Skyhawkson/Skyhawkson-KiCAD-Libraries/Models/HW_MPR_Long-Port_No-Gage.STEP

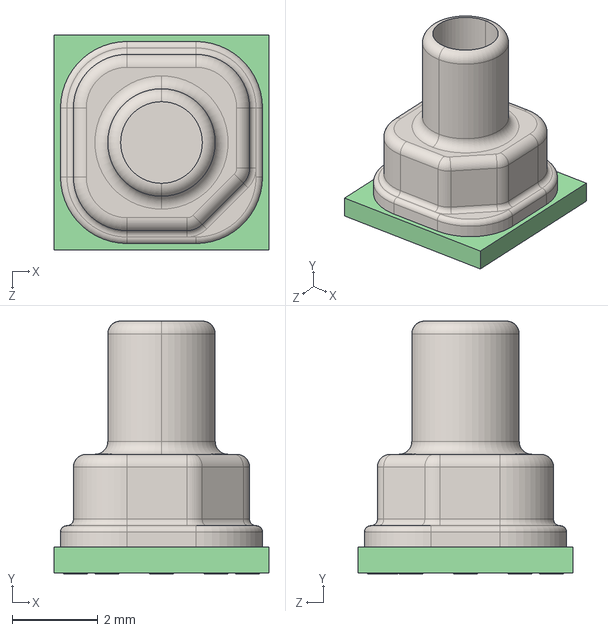
[picture p4: CAD file, 2024-02-28]
Models/HW_MPR_Long-Port_No-Gage.STEP
5.00 x 5.88 x 5.00 mm
