Skyhawkson/Skyhawkson-KiCAD-Libraries/Models/HIROSE_FH12-16S-1SH.STEP

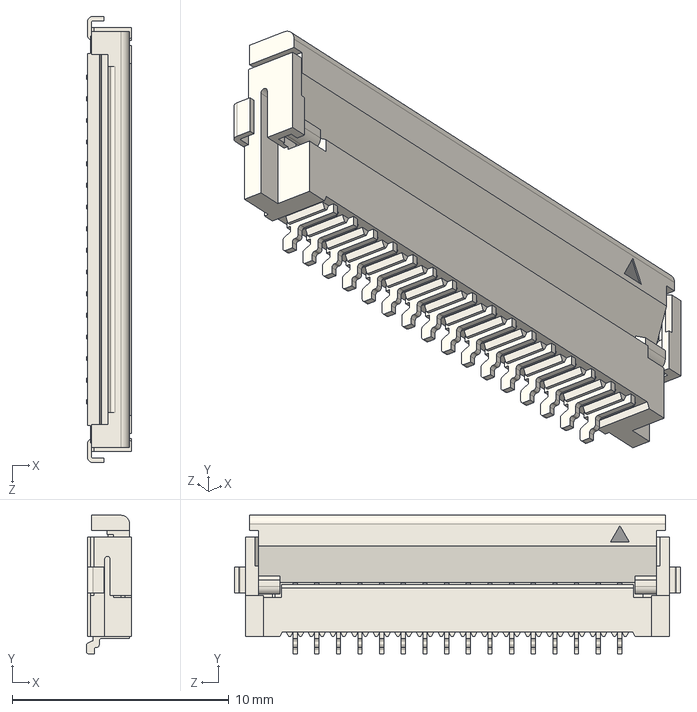
[picture p5: CAD file, 2024-02-18]
Models/HIROSE_FH12-16S-1SH.STEP
2.10 x 6.40 x 20.6 mm
