Skyhawkson/Skyhawkson-KiCAD-Libraries/Models/RPI_RP2040.STEP

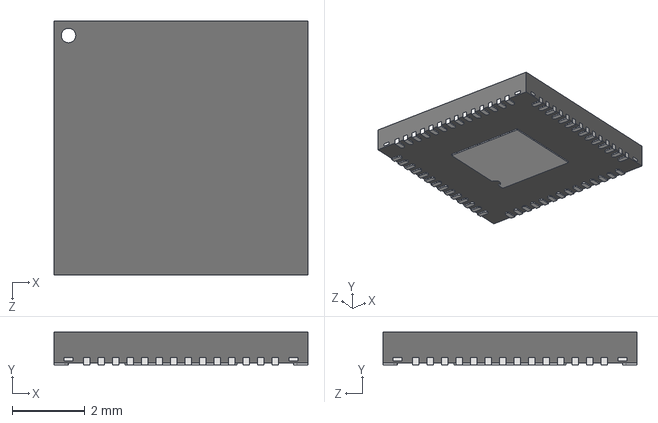
[picture p6: CAD file, 2024-02-08]
Models/RPI_RP2040.STEP
7.00 x 0.9 x 7.00 mm
