Skyhawkson/Skyhawkson-KiCAD-Libraries/Models/KEYSTONE_1043P.STEP

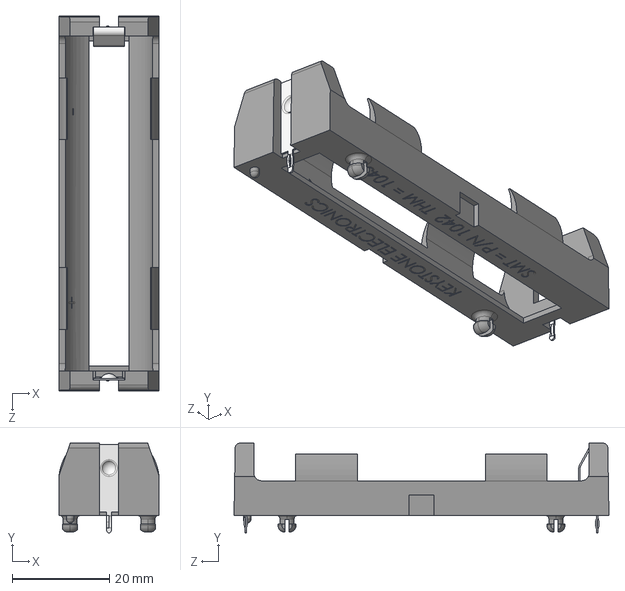
[picture p7: CAD file, 2024-01-29]
Models/KEYSTONE_1043P.STEP
20.7 x 18.5 x 77.1 mm
