Skyhawkson/Skyhawkson-KiCAD-Libraries/Models/WE_WL-SUTW.STEP

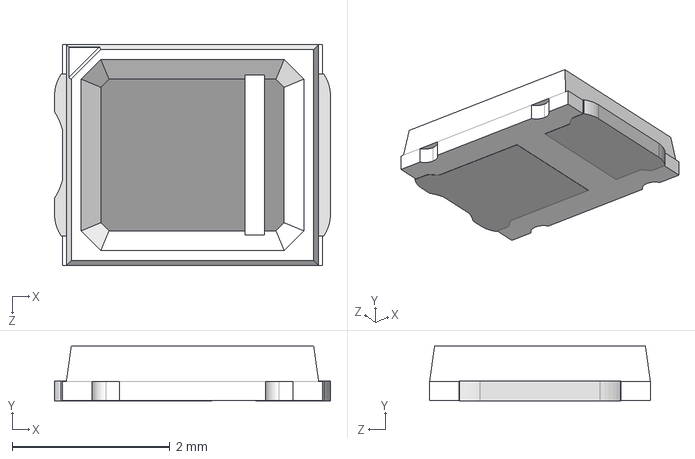
[picture p8: CAD file, 2024-01-17]
Models/WE_WL-SUTW.STEP
3.50 x 0.695 x 2.80 mm
