Skyhawkson/Skyhawkson-KiCAD-Libraries/Models/GENERIC_0402_CAP.step

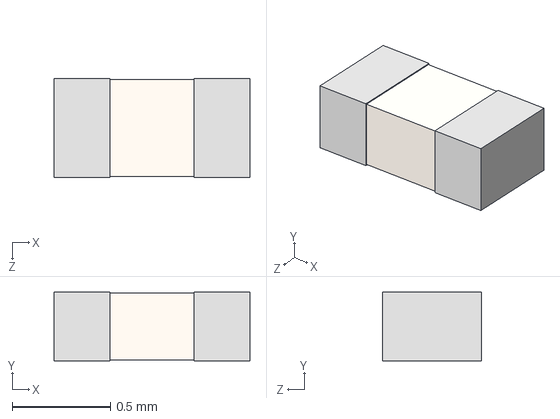
[picture p9: CAD file, 2023-11-19]
Models/GENERIC_0402_CAP.step
0.996 x 0.349 x 0.501 mm
