Skyhawkson/Skyhawkson-KiCAD-Libraries/Models/BIVAR_SLP3-150-100-F.IGS

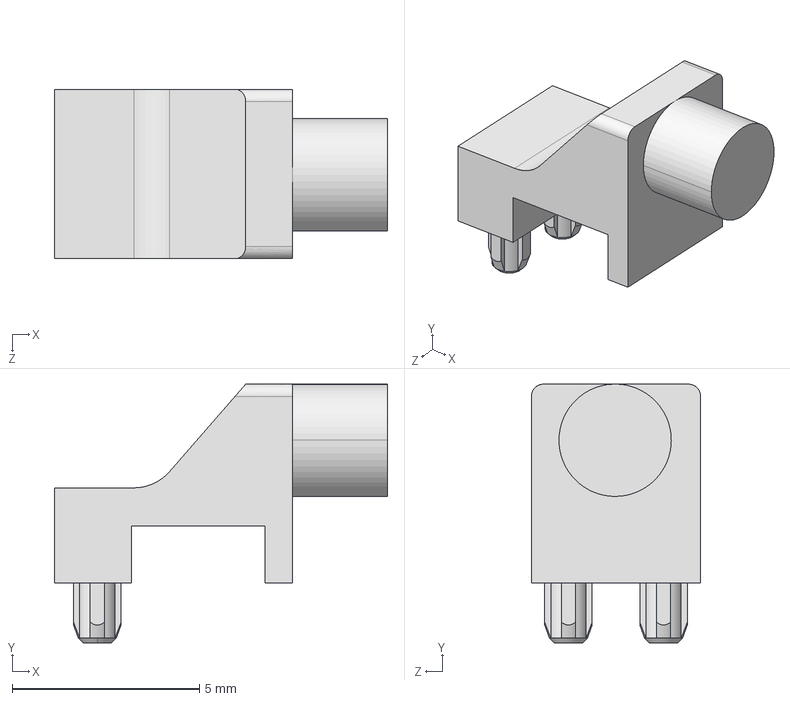
[picture p10: CAD file, 2023-11-09]
Models/BIVAR_SLP3-150-100-F.IGS
8.89 x 6.91 x 4.52 mm
