Skyhawkson/Skyhawkson-KiCAD-Libraries/Models/BIVAR_SLP3-150-250-F.IGS

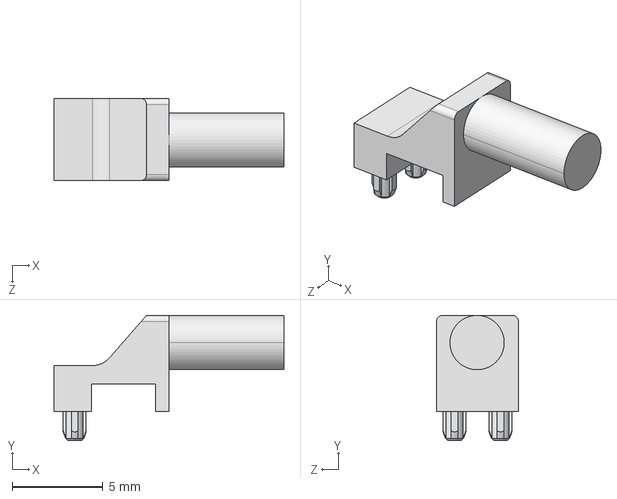
[picture p11: CAD file, 2023-11-05]
Models/BIVAR_SLP3-150-250-F.IGS
12.7 x 6.91 x 4.52 mm
