Skyhawkson/Skyhawkson-KiCAD-Libraries/Models/BOURNS_CAT16-F4.STEP

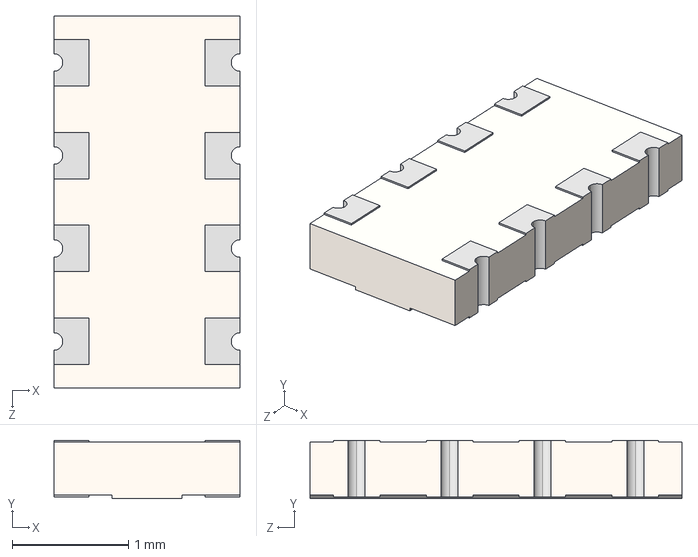
[picture p12: CAD file, 2023-10-05]
Models/BOURNS_CAT16-F4.STEP
1.60 x 0.5 x 3.20 mm
