Skyhawkson/Skyhawkson-KiCAD-Libraries/Models/TI_PW0020A_(TSSOP-20).STEP

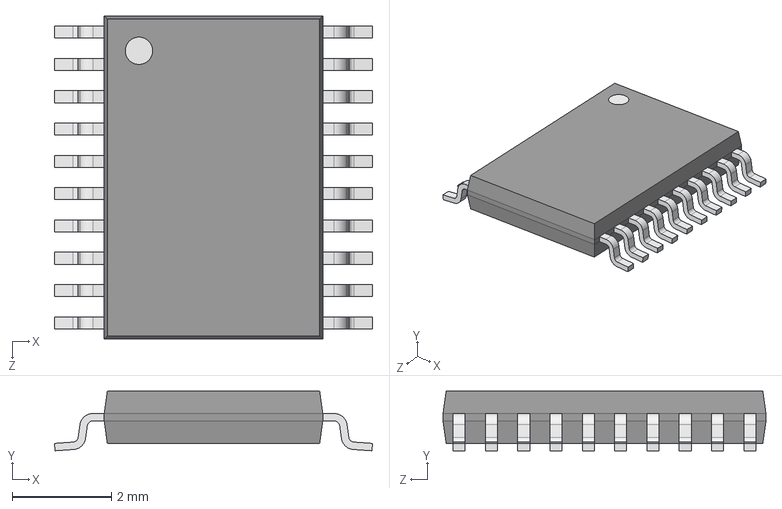
[picture p13: CAD file, 2023-09-29]
Models/TI_PW0020A_(TSSOP-20).STEP
6.40 x 1.20 x 6.50 mm
