Skyhawkson/Skyhawkson-KiCAD-Libraries/Models/WE-CNSW-0603.STEP

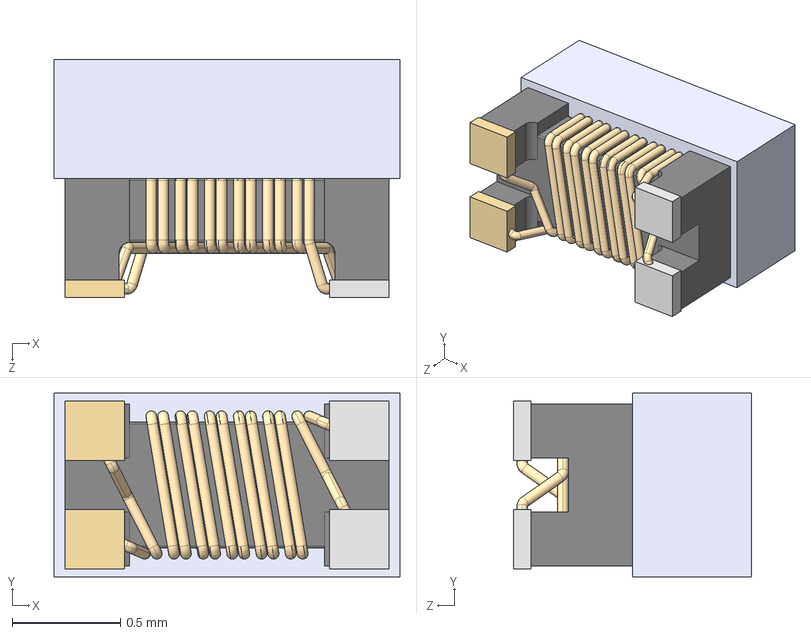
[picture p14: CAD file, 2023-06-05]
Models/WE-CNSW-0603.STEP
1.60 x 0.85 x 1.10 mm
Epoxy.stp.STEP.STEP
Ferrite.stp.STEP.STEP
Ferrite-0.stp.STEP.STEP
Ferrite-1.stp.STEP.STEP
Pins.stp.STEP.STEP
Pins-2.stp.STEP.STEP
Pins-3.stp.STEP.STEP
Pins-4.stp.STEP.STEP
