Skyhawkson/Skyhawkson-KiCAD-Libraries/Models/BOURNS_SRP5030TA.STEP

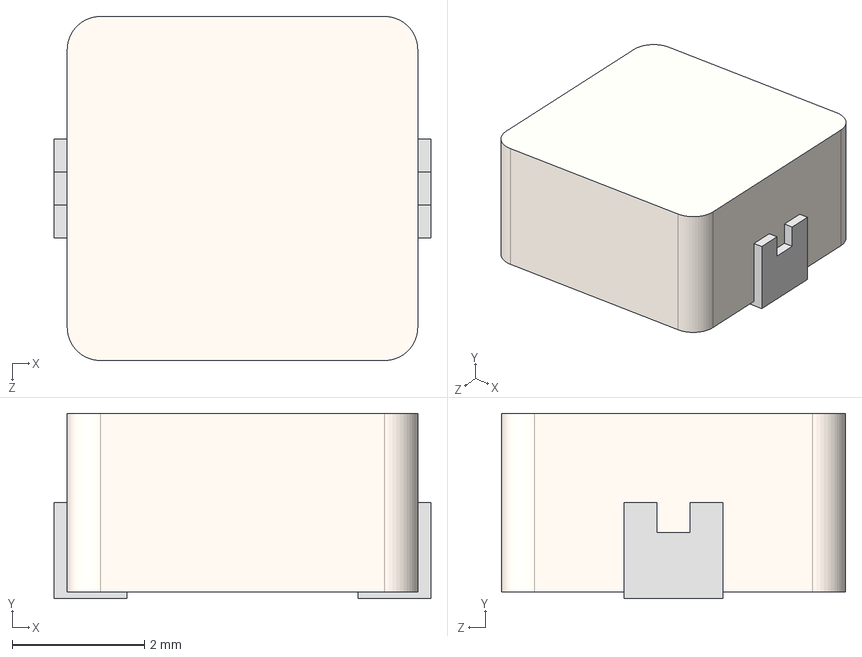
[picture p15: CAD file, 2023-06-05]
Models/BOURNS_SRP5030TA.STEP
5.70 x 2.80 x 5.20 mm
