Skyhawkson/Skyhawkson-KiCAD-Libraries/Models/GENERIC_DO-214BA.STEP

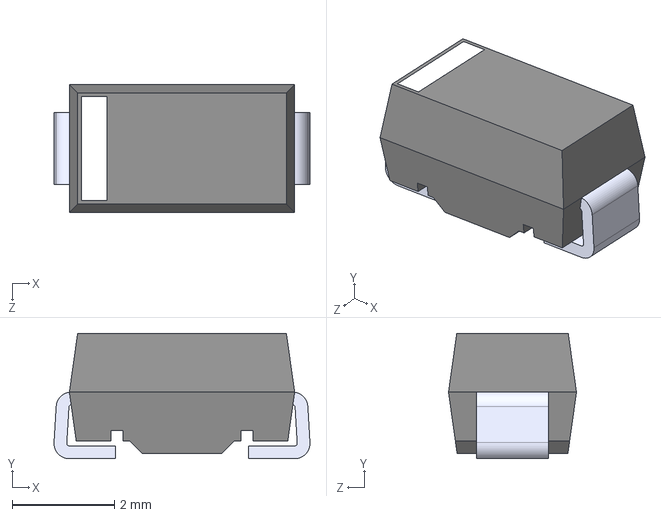
[picture p16: CAD file, 2023-05-29]
Models/GENERIC_DO-214BA.STEP
5.00 x 2.45 x 2.50 mm
