Skyhawkson/Skyhawkson-KiCAD-Libraries/Models/SAMTEC_LSS-120-02-F-DV-A.stp

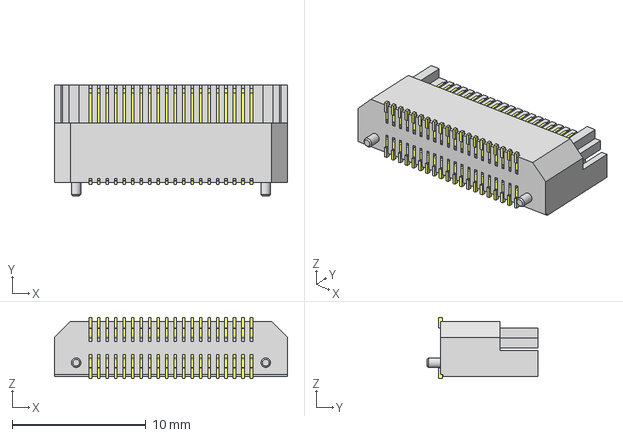
[picture p17: CAD file, 2023-05-29]
Models/SAMTEC_LSS-120-02-F-DV-A.stp
17.4 x 8.30 x 4.60 mm
C-185-20-02
LSS-20-02-A-_socket
