Skyhawkson/Skyhawkson-KiCAD-Libraries/Models/TOR_SOT89-5.STEP

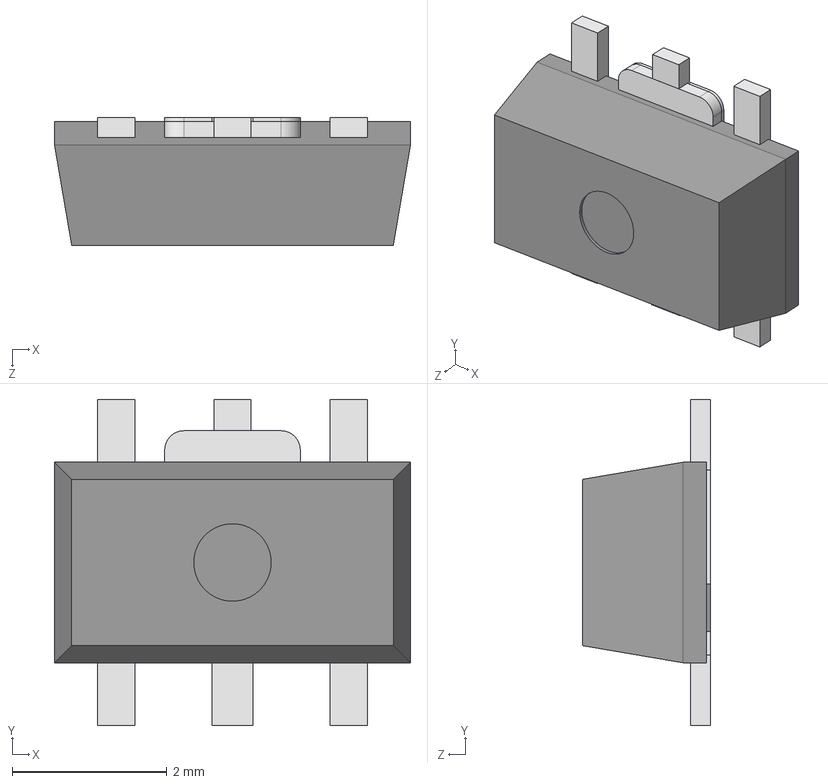
[picture p18: CAD file, 2023-04-02]
Models/TOR_SOT89-5.STEP
4.60 x 4.22 x 1.65 mm
