Skyhawkson/Skyhawkson-KiCAD-Libraries/Models/LF_494_(0603).STEP

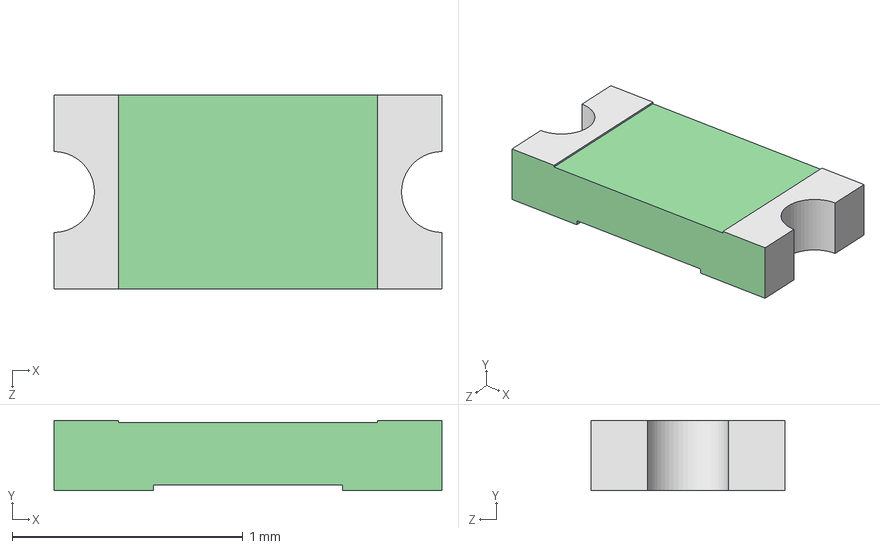
[picture p19: CAD file, 2023-03-20]
Models/LF_494_(0603).STEP
1.68 x 0.305 x 0.84 mm
