Skyhawkson/Skyhawkson-KiCAD-Libraries/Models/AMP_MSPE-J2L0-B01-REVT3.STEP

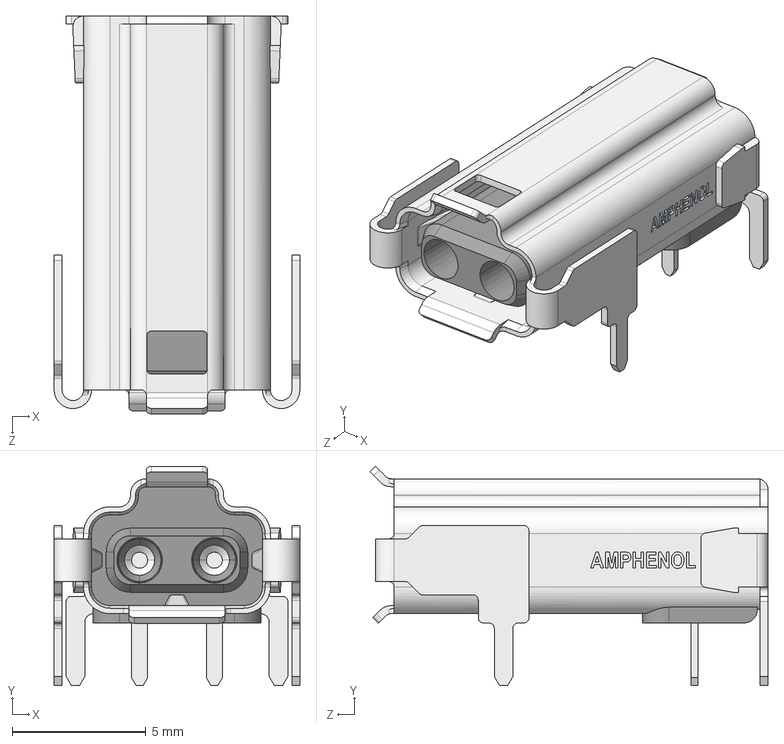
[picture p20: CAD file, 2023-03-18]
Models/AMP_MSPE-J2L0-B01-REVT3.STEP
9.20 x 8.22 x 14.9 mm
