Skyhawkson/Skyhawkson-KiCAD-Libraries/Models/AD_ADIN1110.step

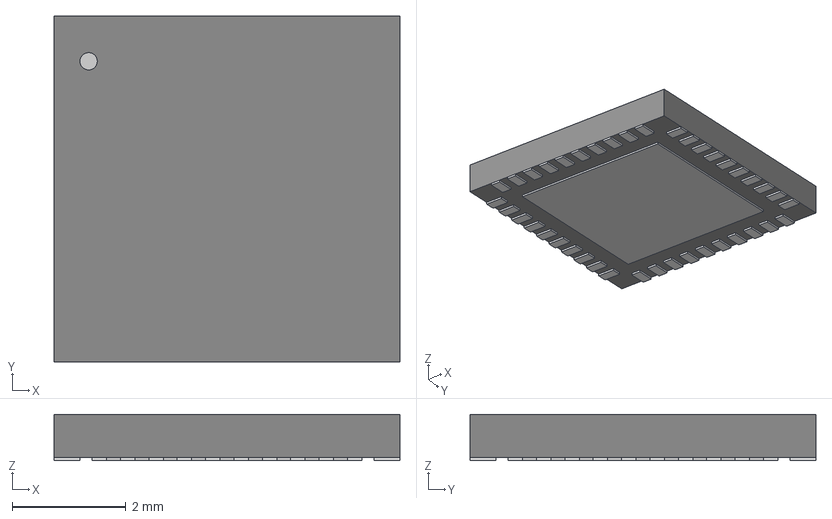
[picture p21: CAD file, 2023-03-06]
Models/AD_ADIN1110.step
6.10 x 6.10 x 0.815 mm
