Skyhawkson/Skyhawkson-KiCAD-Libraries/Models/GENERIC_SOT23-6.STEP

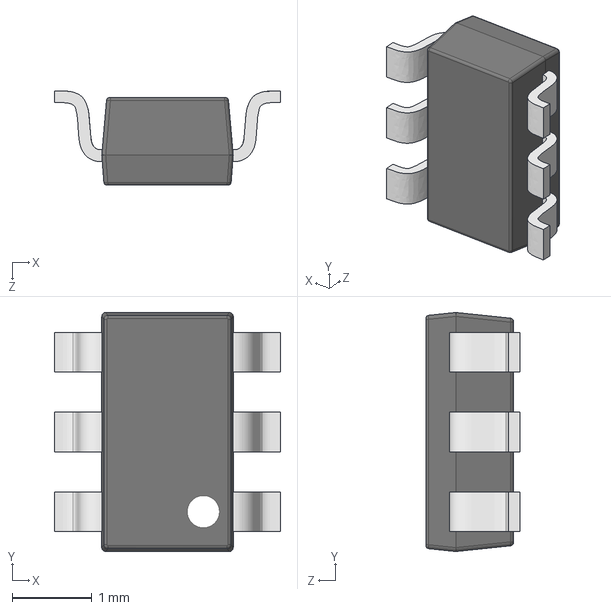
[picture p22: CAD file, 2023-02-12]
Models/GENERIC_SOT23-6.STEP
2.84 x 3.00 x 1.18 mm
