Skyhawkson/Skyhawkson-KiCAD-Libraries/Models/KEYSTONE_575-4.STEP

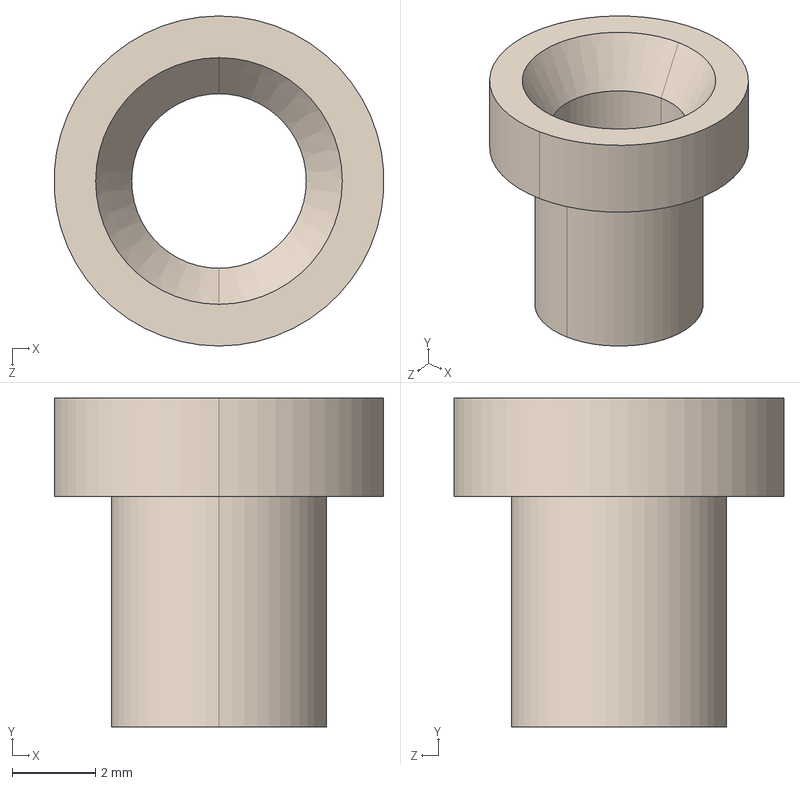
[picture p23: CAD file, 2023-01-21]
Models/KEYSTONE_575-4.STEP
7.91 x 7.89 x 7.92 mm
