Skyhawkson/Skyhawkson-KiCAD-Libraries/Models/MAXIM_W352A2+1.STEP

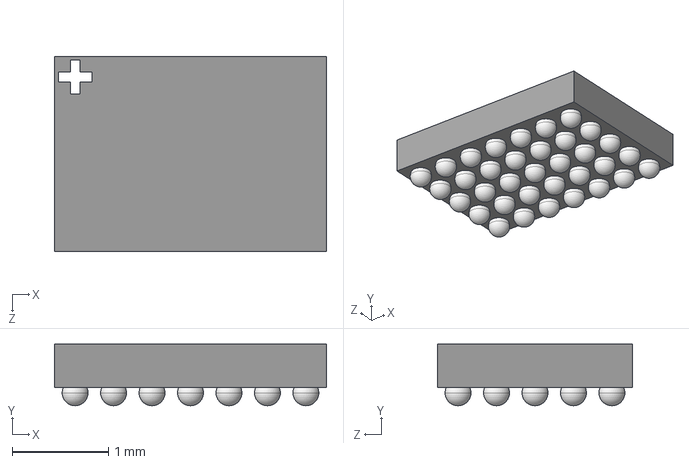
[picture p24: CAD file, 2023-01-15]
Models/MAXIM_W352A2+1.STEP
2.83 x 0.64 x 2.03 mm
