Skyhawkson/Skyhawkson-KiCAD-Libraries/Models/ROHM_HSMT8_NOMINAL.step

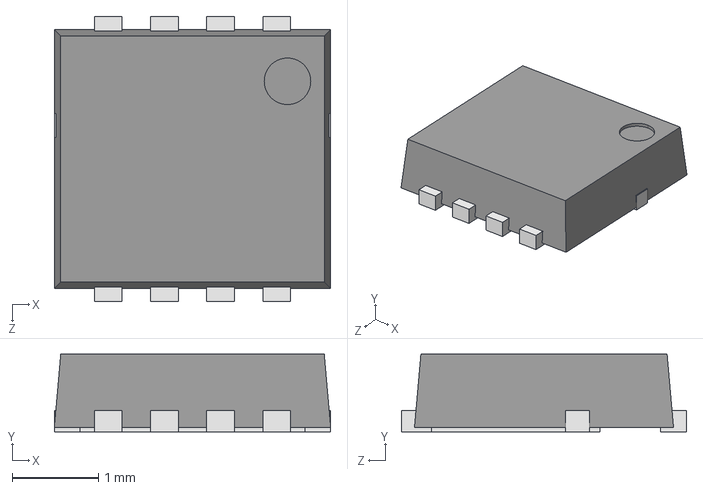
[picture p25: CAD file, 2022-08-25]
Models/ROHM_HSMT8_NOMINAL.step
3.20 x 0.9 x 3.30 mm
