Skyhawkson/Skyhawkson-KiCAD-Libraries/Models/DIODES_POWERDI5.step

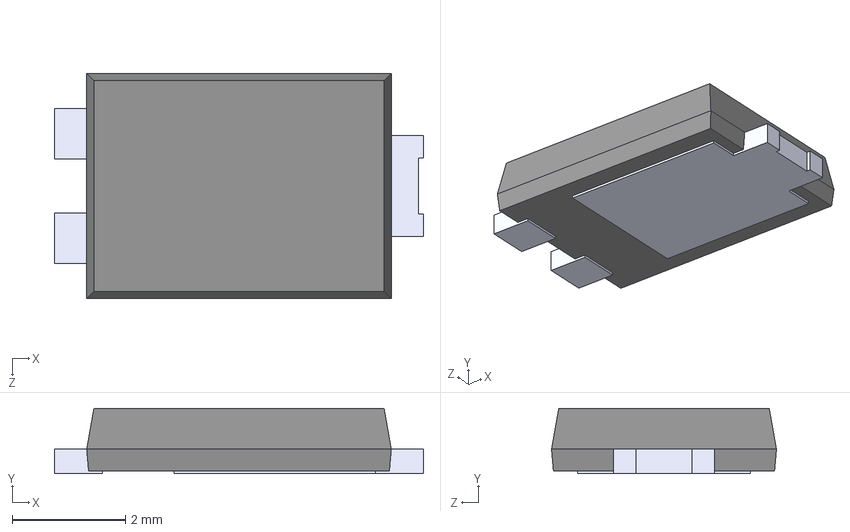
[picture p26: CAD file, 2022-08-09]
Models/DIODES_POWERDI5.step
6.50 x 1.15 x 3.97 mm
