Skyhawkson/Skyhawkson-KiCAD-Libraries/Models/GENERIC_0603_RES.step

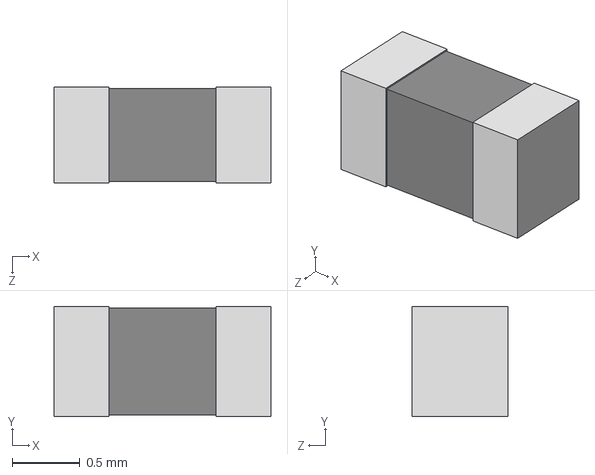
[picture p27: CAD file, 2022-08-09]
Models/GENERIC_0603_RES.step
1.60 x 0.812 x 0.711 mm
