Skyhawkson/Skyhawkson-KiCAD-Libraries/Models/GENERIC_0805_RES.step

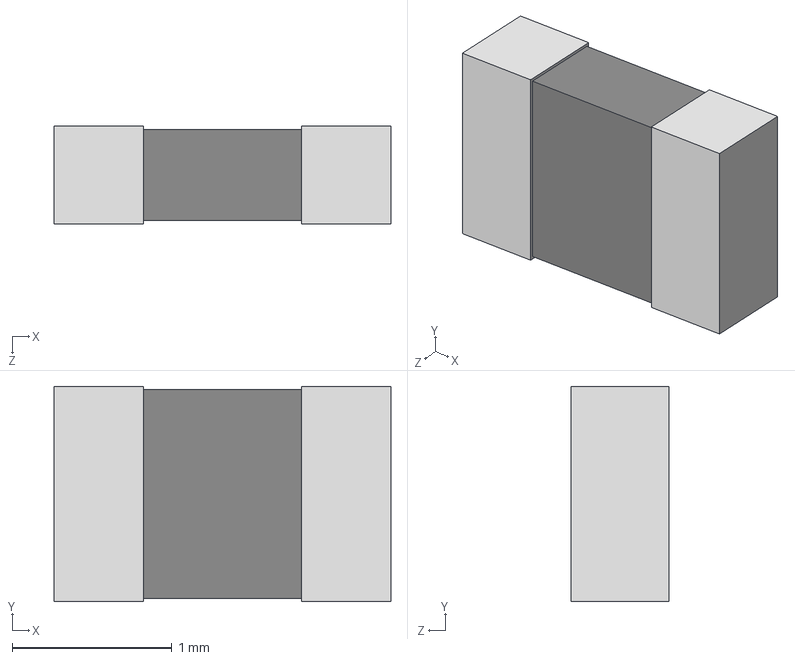
[picture p28: CAD file, 2022-08-09]
Models/GENERIC_0805_RES.step
2.11 x 1.35 x 0.61 mm
