Skyhawkson/Skyhawkson-KiCAD-Libraries/Models/TOR-SOT25.step

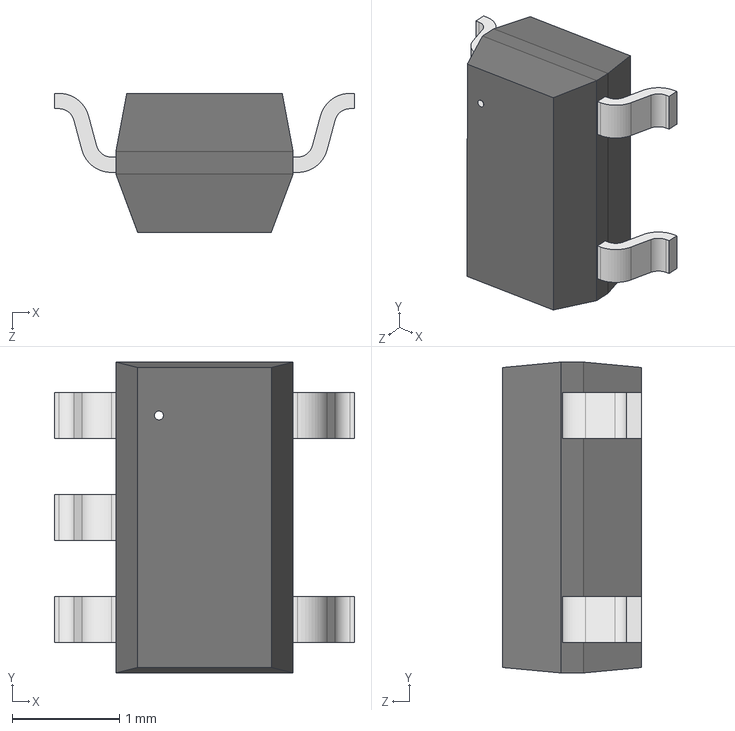
[picture p29: CAD file, 2022-07-27]
Models/TOR-SOT25.step
2.79 x 2.90 x 1.30 mm
