Skyhawkson/Skyhawkson-KiCAD-Libraries/Models/ROHM_HTSOP-J8.step

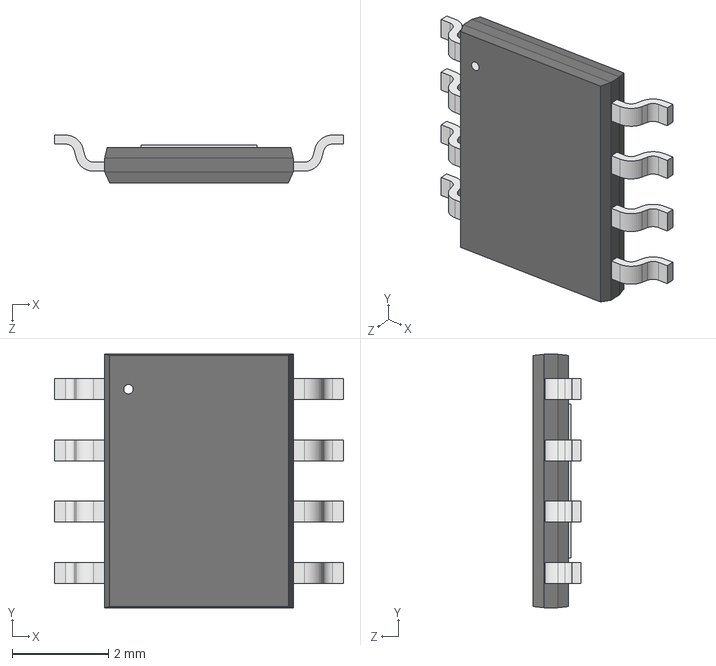
[picture p30: CAD file, 2022-07-27]
Models/ROHM_HTSOP-J8.step
5.99 x 5.26 x 0.993 mm
