Skyhawkson/Skyhawkson-KiCAD-Libraries/Models/MIC_SOT23-5LD-PL-1.step

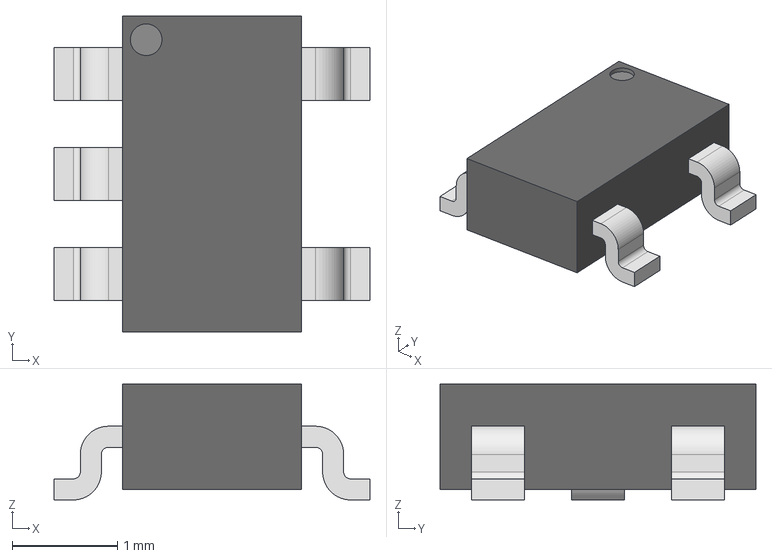
[picture p31: CAD file, 2022-07-27]
Models/MIC_SOT23-5LD-PL-1.step
3.00 x 3.00 x 1.10 mm
