Skyhawkson/Skyhawkson-KiCAD-Libraries/Models/CK_PTS815.step

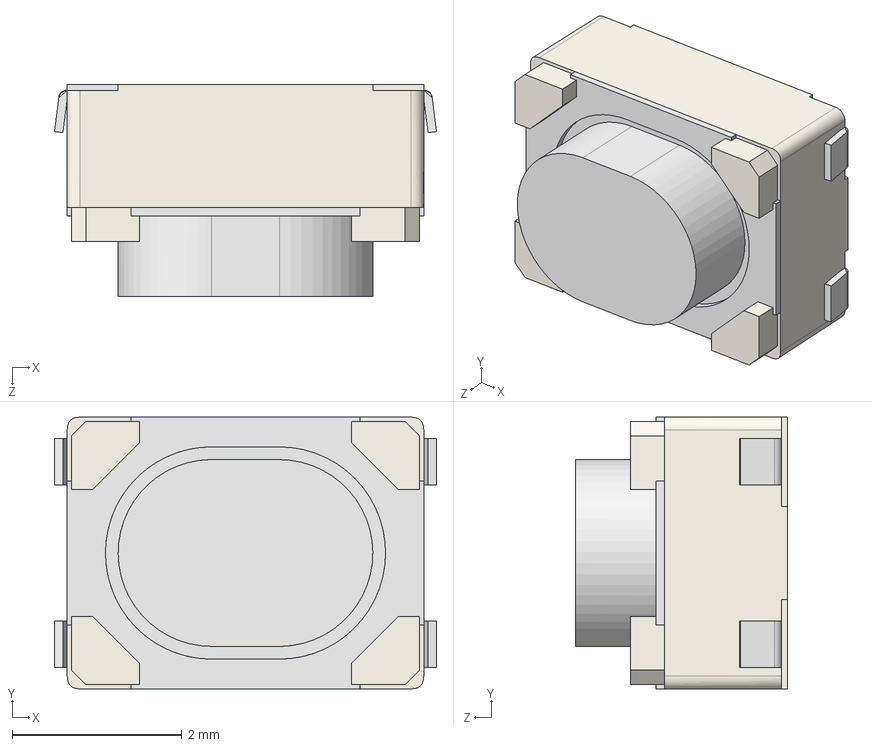
[picture p32: CAD file, 2022-07-25]
Models/CK_PTS815.step
4.50 x 3.20 x 2.50 mm
1.stp
1-0.stp
1-1.stp
