Skyhawkson/Skyhawkson-KiCAD-Libraries/Models/MURATA_PKMCS.step

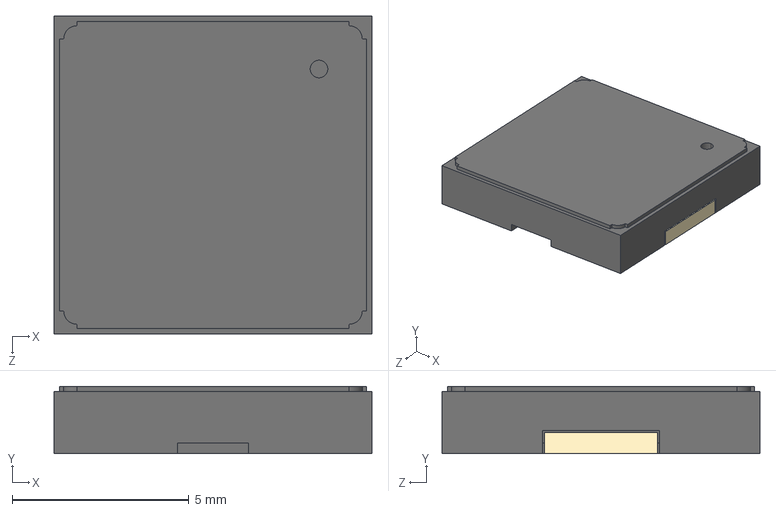
[picture p33: CAD file, 2022-07-25]
Models/MURATA_PKMCS.step
9.00 x 1.90 x 9.00 mm
