Skyhawkson/Skyhawkson-KiCAD-Libraries/Models/HARWIN_S1751-XX.step

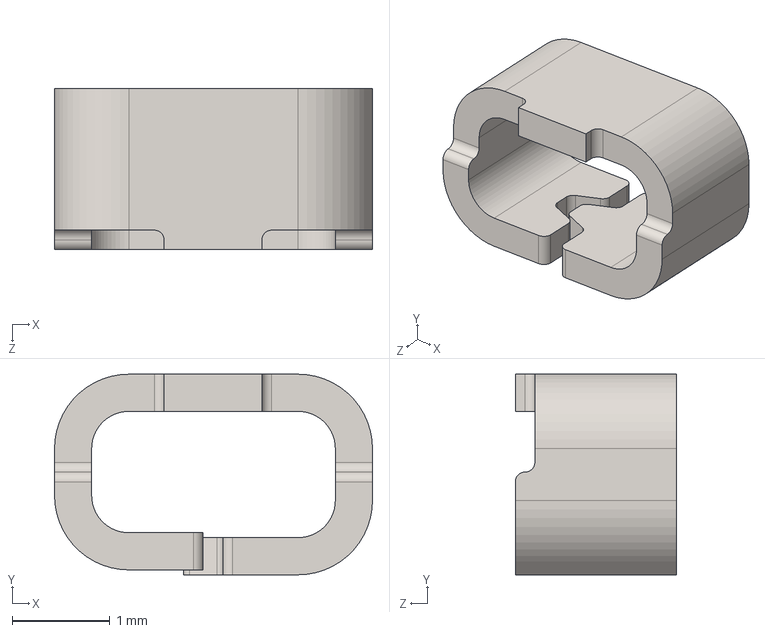
[picture p34: CAD file, 2022-07-25]
Models/HARWIN_S1751-XX.step
3.25 x 2.05 x 1.65 mm
