Skyhawkson/Skyhawkson-KiCAD-Libraries/Models/ABRACON_ABM8.step

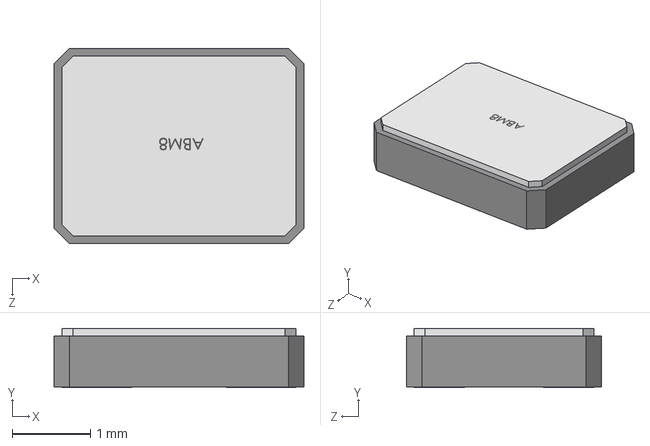
[picture p35: CAD file, 2022-07-25]
Models/ABRACON_ABM8.step
3.20 x 0.761 x 2.50 mm
