Skyhawkson/Skyhawkson-KiCAD-Libraries/Models/ABRACON_ABS25.step

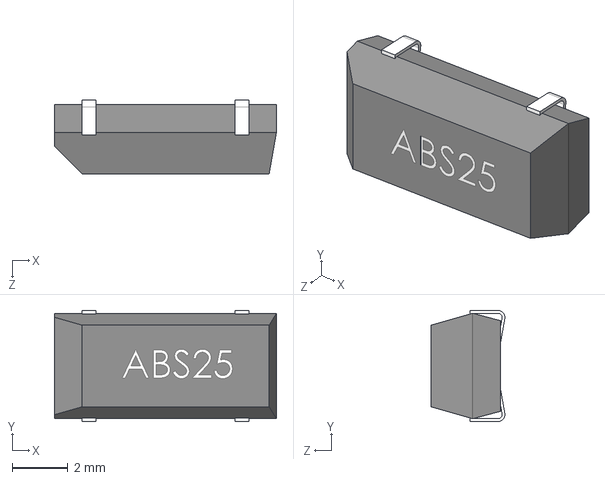
[picture p36: CAD file, 2022-07-25]
Models/ABRACON_ABS25.step
8.00 x 4.00 x 2.66 mm
