Skyhawkson/Skyhawkson-KiCAD-Libraries/Models/WS_WS2812B-2020.step

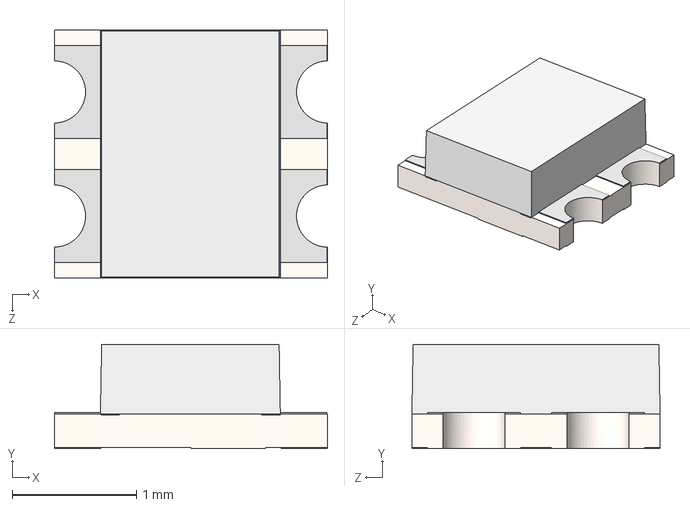
[picture p37: CAD file, 2022-07-25]
Models/WS_WS2812B-2020.step
2.20 x 0.84 x 2.00 mm
WS2812B
WS2812B_Lens
