Skyhawkson/Skyhawkson-KiCAD-Libraries/Models/SUNLED_XZxxxxxx45S-9.step

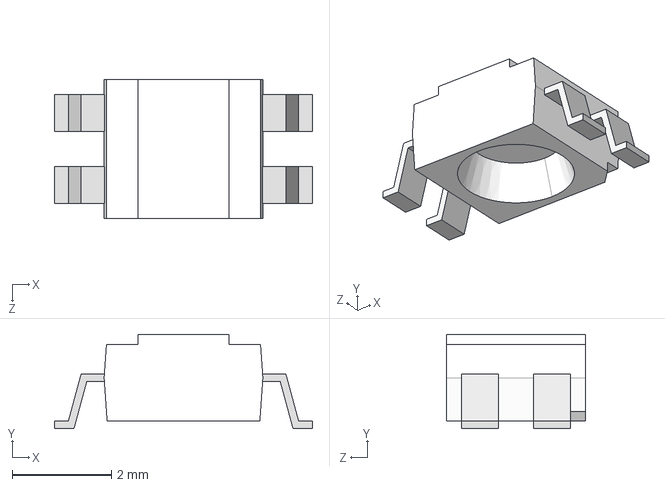
[picture p38: CAD file, 2022-07-25]
Models/SUNLED_XZxxxxxx45S-9.step
5.20 x 1.90 x 2.80 mm
