Skyhawkson/Skyhawkson-KiCAD-Libraries/Models/LITE-ON_LTP-305X.step

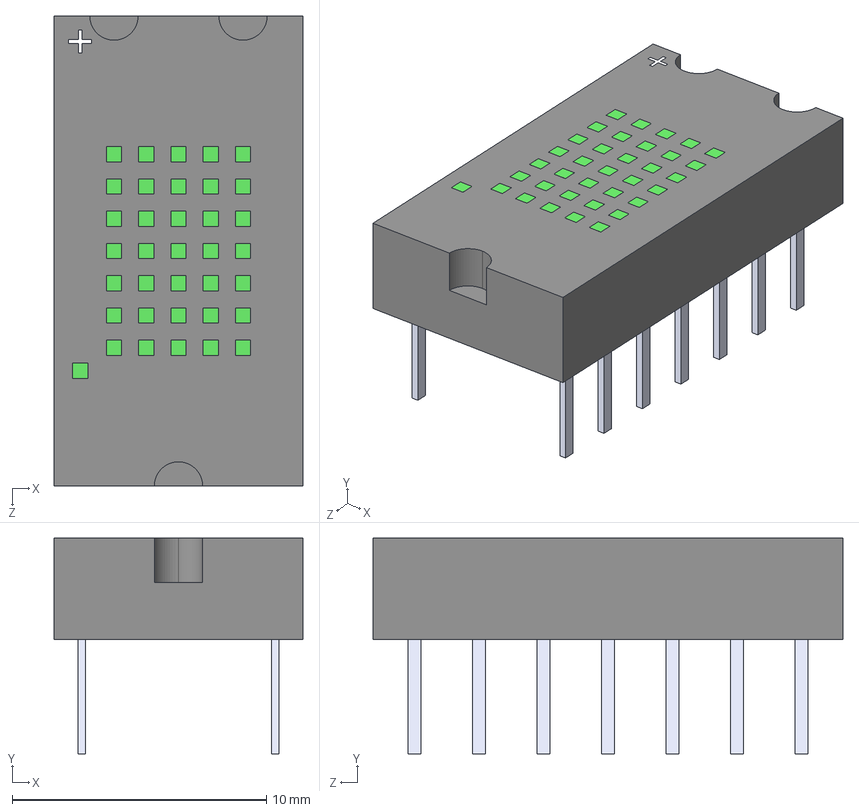
[picture p39: CAD file, 2022-07-25]
Models/LITE-ON_LTP-305X.step
9.80 x 8.50 x 18.5 mm
