Skyhawkson/Skyhawkson-KiCAD-Libraries/Models/OSRAM_0603.step

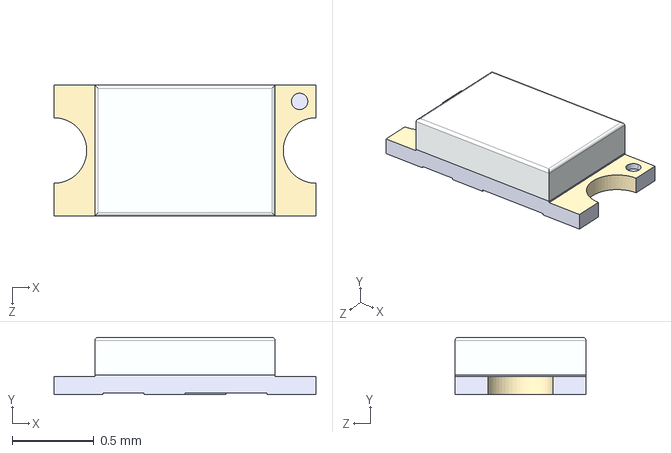
[picture p40: CAD file, 2022-07-25]
Models/OSRAM_0603.step
1.60 x 0.35 x 0.8 mm
OSRAM_0603_BASE
OSRAM_0603_LENS
