Skyhawkson/Skyhawkson-KiCAD-Libraries/Models/OSRAM_0805.step

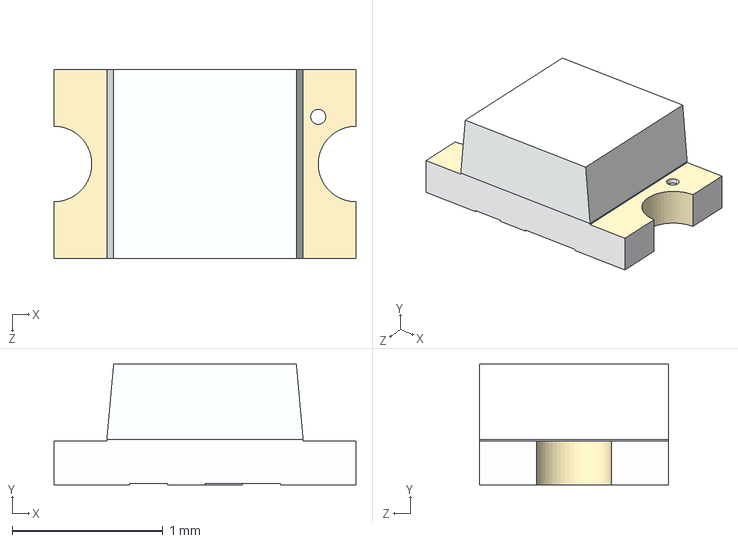
[picture p41: CAD file, 2022-07-25]
Models/OSRAM_0805.step
2.00 x 0.8 x 1.25 mm
OSRAM_0805_BASE
OSRAM_0805_LENS
