Skyhawkson/Skyhawkson-KiCAD-Libraries/Models/MURATA_JELF243A_0026S-01_(0603).step

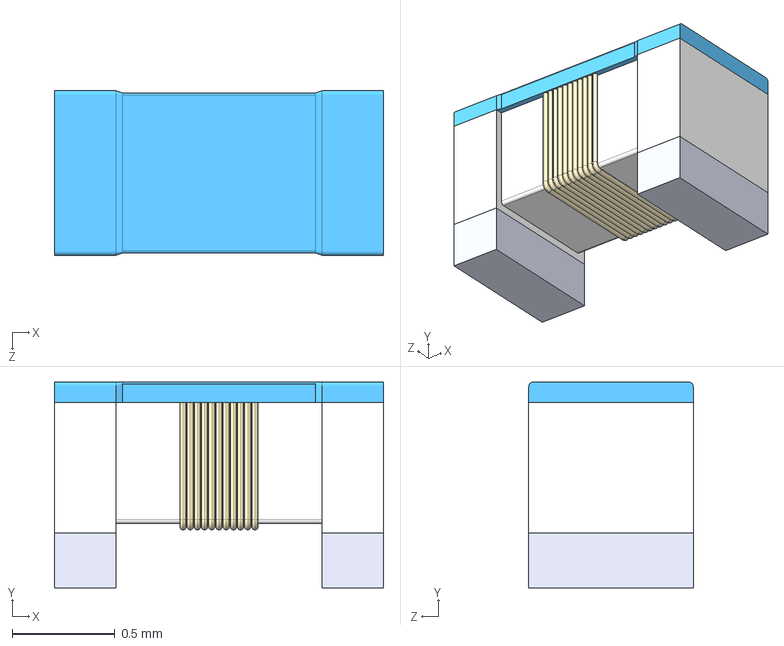
[picture p42: CAD file, 2022-07-23]
Models/MURATA_JELF243A_0026S-01_(0603).step
1.60 x 1.00 x 0.8 mm
