Skyhawkson/Skyhawkson-KiCAD-Libraries/Models/TI_PW0016A_(TSSOP-16).step

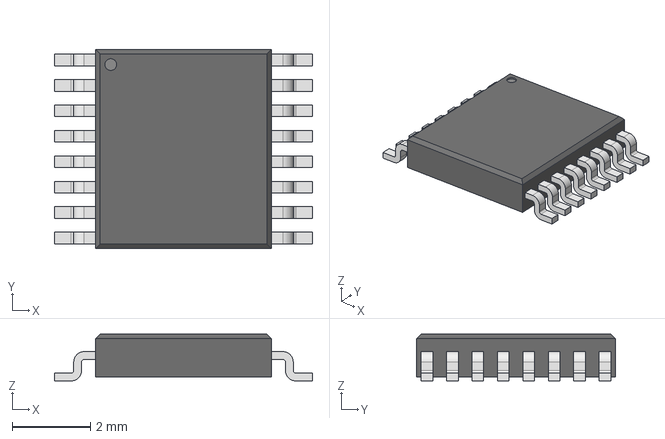
[picture p43: CAD file, 2022-07-23]
Models/TI_PW0016A_(TSSOP-16).step
6.60 x 5.10 x 1.20 mm
