Skyhawkson/Skyhawkson-KiCAD-Libraries/Models/NEXPERIA_SOT361-1_(TSSOP-28).step

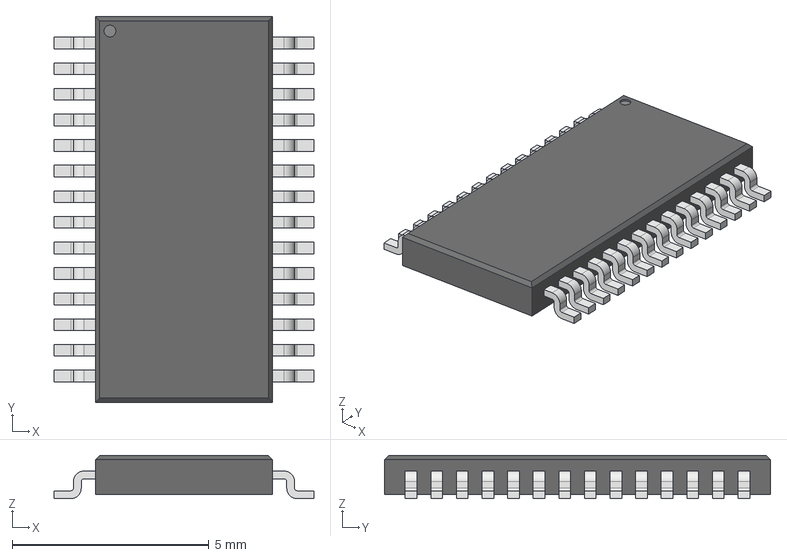
[picture p44: CAD file, 2022-07-23]
Models/NEXPERIA_SOT361-1_(TSSOP-28).step
6.60 x 9.80 x 1.10 mm
