Skyhawkson/Skyhawkson-KiCAD-Libraries/Models/TI_PBS_(S-PQFP-G32).step

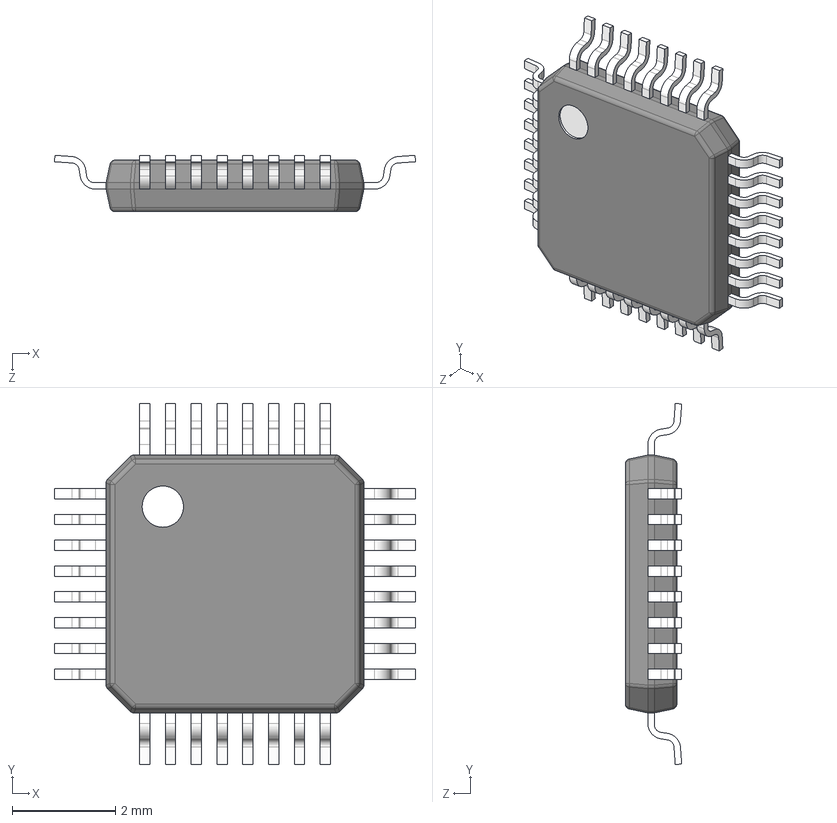
[picture p45: CAD file, 2022-07-23]
Models/TI_PBS_(S-PQFP-G32).step
7.00 x 7.00 x 1.09 mm
BODY-TQFP.stp
LEAD-TQFP.stp x 32
