Skyhawkson/Skyhawkson-KiCAD-Libraries/Models/NEXPERIA_SOT360-1_(TSSOP20).step

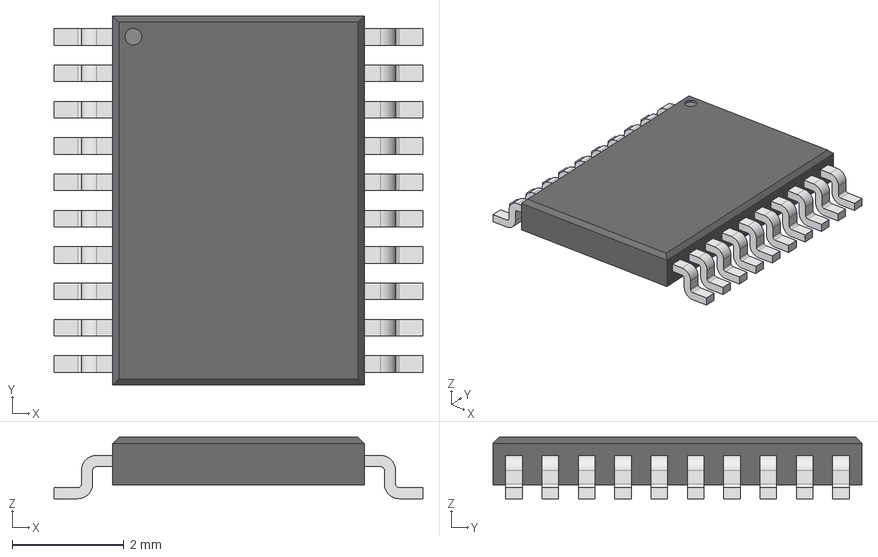
[picture p46: CAD file, 2022-07-22]
Models/NEXPERIA_SOT360-1_(TSSOP20).step
6.60 x 6.60 x 1.10 mm
