Skyhawkson/Skyhawkson-KiCAD-Libraries/Models/MCP_C04-2051A_(SOIC-18).step

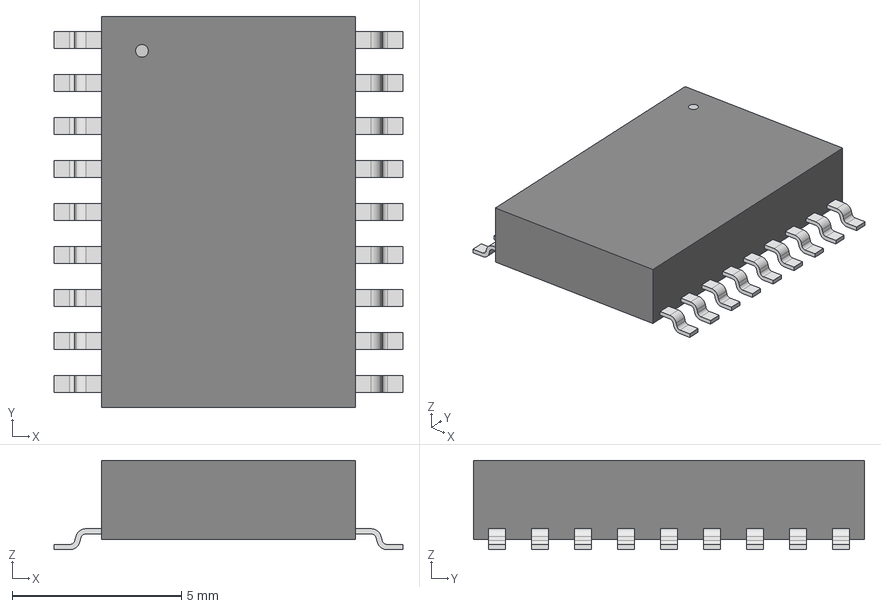
[picture p47: CAD file, 2022-07-22]
Models/MCP_C04-2051A_(SOIC-18).step
10.3 x 11.6 x 2.64 mm
