Skyhawkson/Skyhawkson-KiCAD-Libraries/Models/TI_D0008A_(SOIC-8).step

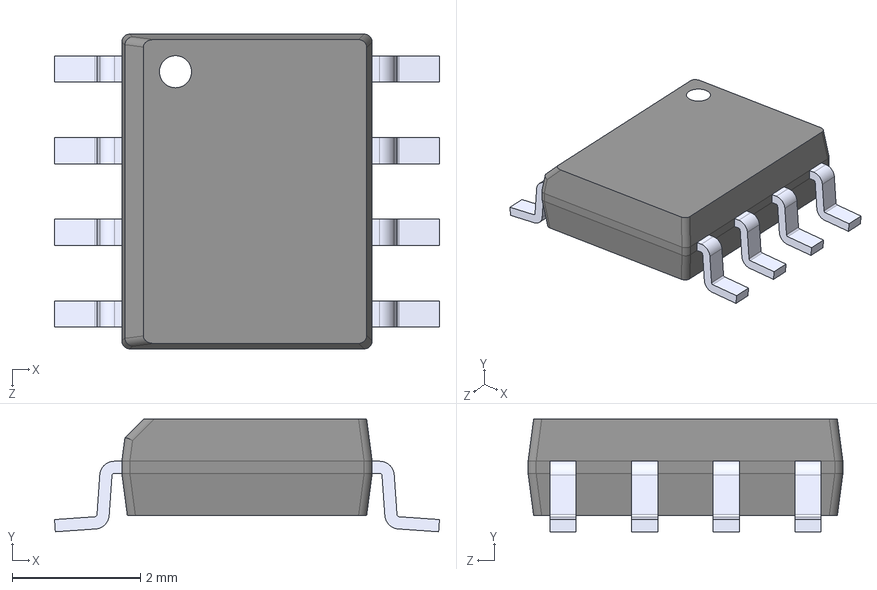
[picture p48: CAD file, 2022-07-22]
Models/TI_D0008A_(SOIC-8).step
5.99 x 1.75 x 4.90 mm
