Skyhawkson/Skyhawkson-KiCAD-Libraries/Models/MAXIM_MAX7456.step

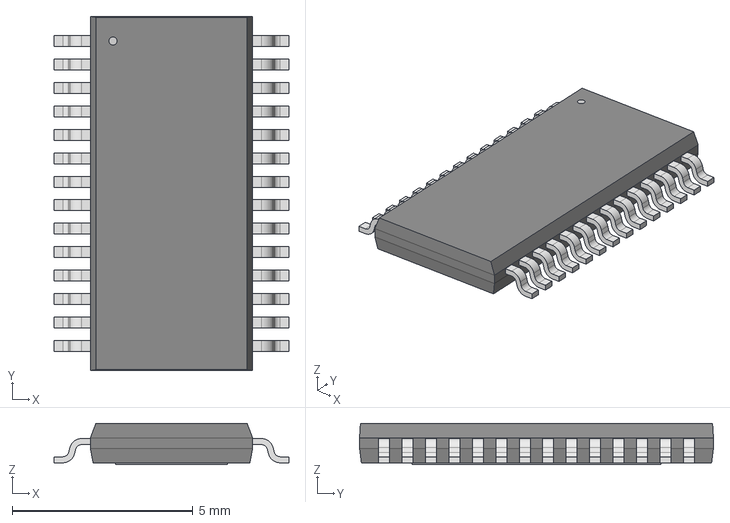
[picture p49: CAD file, 2022-07-22]
Models/MAXIM_MAX7456.step
6.50 x 9.80 x 1.15 mm
