Skyhawkson/Skyhawkson-KiCAD-Libraries/Models/NEXPERIA_SOT403-1_(TSSOP-16).step

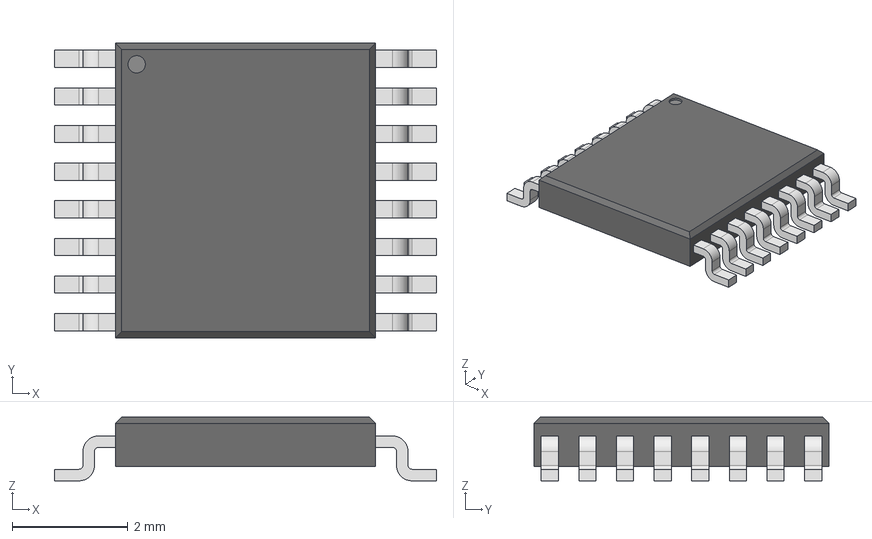
[picture p50: CAD file, 2022-07-22]
Models/NEXPERIA_SOT403-1_(TSSOP-16).step
6.60 x 5.10 x 1.10 mm
