Skyhawkson/Skyhawkson-KiCAD-Libraries/Models/ISSI_QFN-24_4x4.step

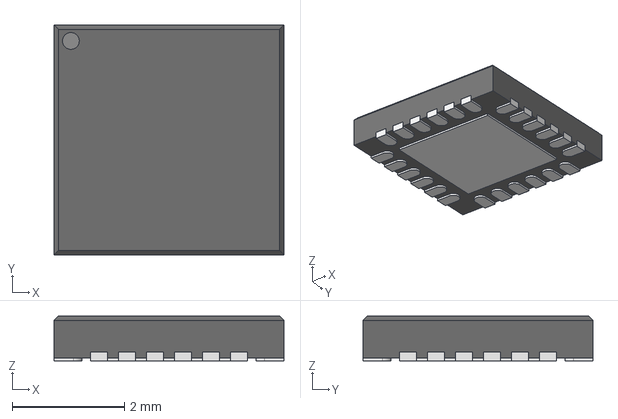
[picture p51: CAD file, 2022-07-21]
Models/ISSI_QFN-24_4x4.step
4.10 x 4.10 x 0.8 mm
