Skyhawkson/Skyhawkson-KiCAD-Libraries/Models/FTDI_000565_(SSOP-20).step

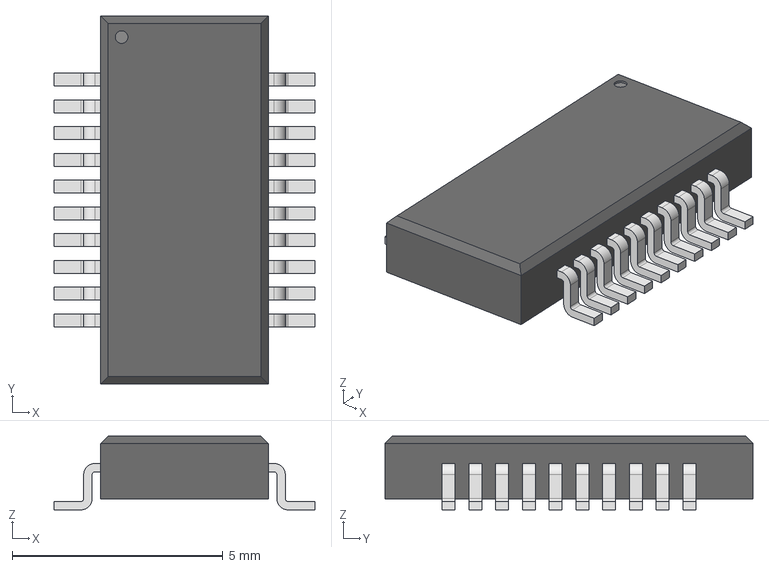
[picture p52: CAD file, 2022-07-21]
Models/FTDI_000565_(SSOP-20).step
6.20 x 8.74 x 1.75 mm
