Skyhawkson/Skyhawkson-KiCAD-Libraries/Models/ALLEGO_LC_(SOIC-8).step

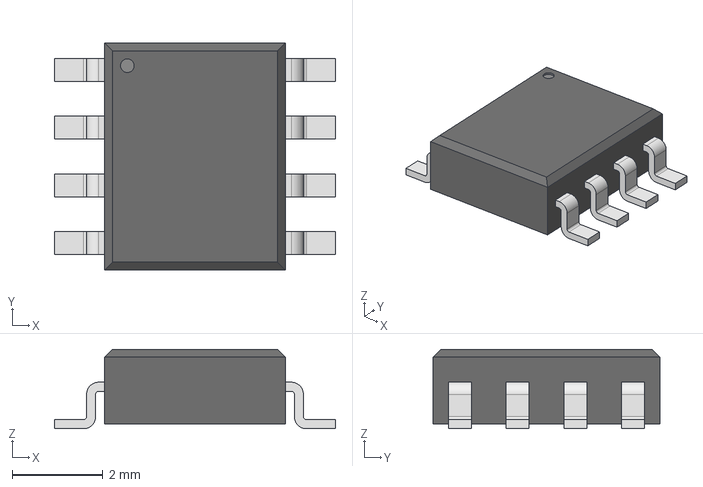
[picture p53: CAD file, 2022-07-21]
Models/ALLEGO_LC_(SOIC-8).step
6.19 x 5.00 x 1.75 mm
