Skyhawkson/Skyhawkson-KiCAD-Libraries/Models/ADESTO_8S4_(SON-8).step

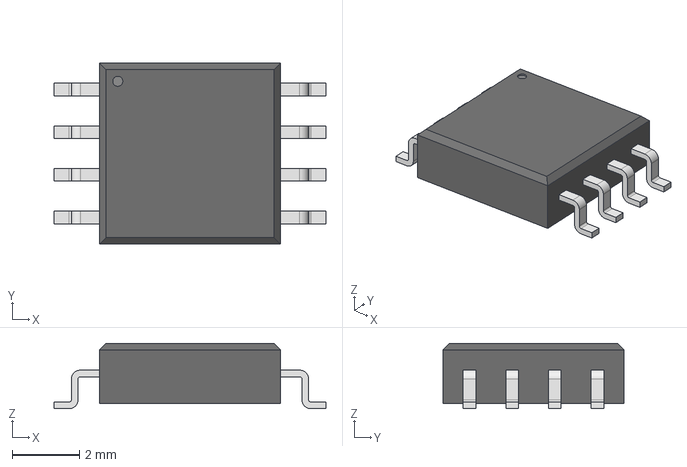
[picture p54: CAD file, 2022-07-21]
Models/ADESTO_8S4_(SON-8).step
8.10 x 5.38 x 1.95 mm
