Skyhawkson/Skyhawkson-KiCAD-Libraries/Models/LF_AXGD10603.step

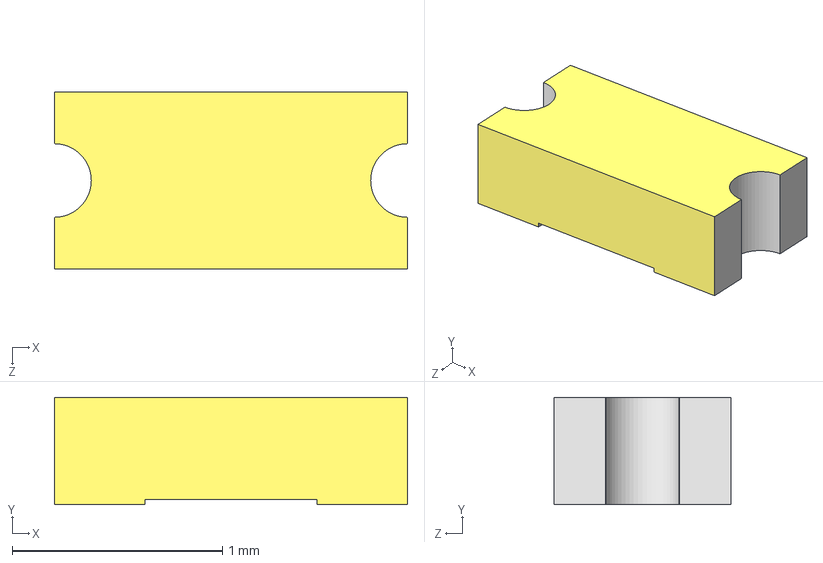
[picture p55: CAD file, 2022-07-20]
Models/LF_AXGD10603.step
1.68 x 0.51 x 0.84 mm
