Skyhawkson/Skyhawkson-KiCAD-Libraries/Models/ONSEMI_SOT-23_(CASE 318).step

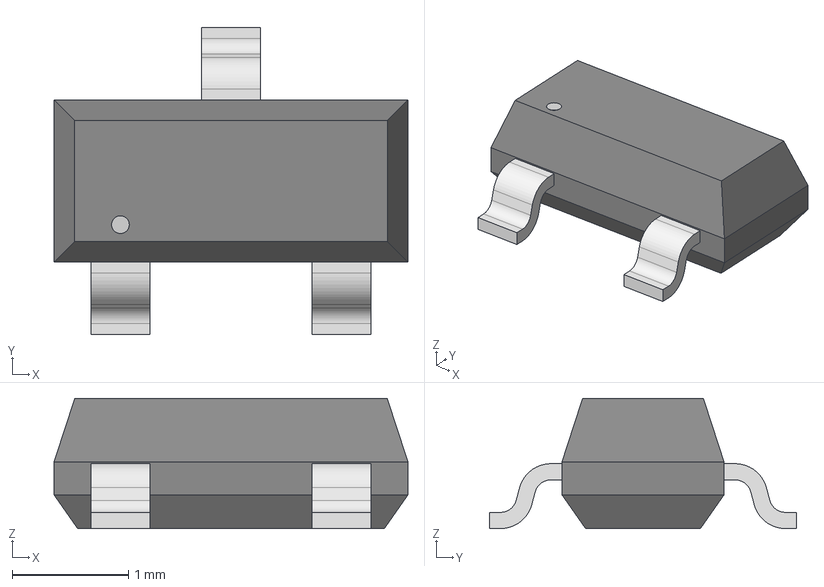
[picture p56: CAD file, 2022-07-20]
Models/ONSEMI_SOT-23_(CASE 318).step
3.05 x 2.64 x 1.12 mm
