Skyhawkson/Skyhawkson-KiCAD-Libraries/Models/CNC_3220-10-0300-00.step

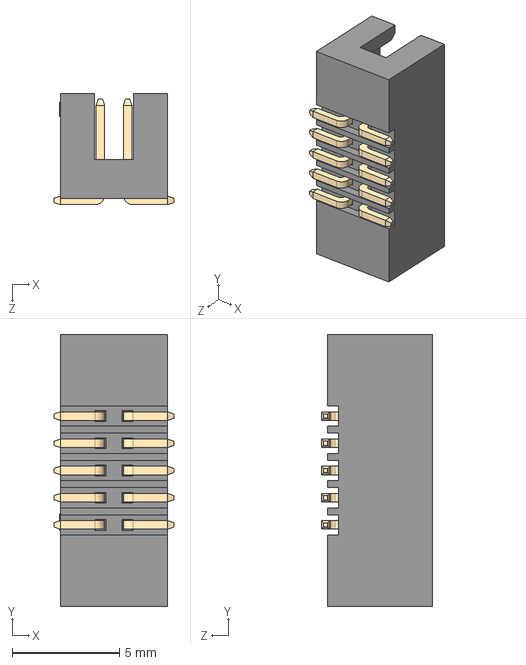
[picture p57: CAD file, 2022-07-20]
Models/CNC_3220-10-0300-00.step
5.60 x 12.7 x 5.20 mm
801-2195-10-K.STP
2195SM-PIN.STP x 10
