Skyhawkson/Skyhawkson-KiCAD-Libraries/Models/SAMTEC_MTSW-109-24-G-T-225.step

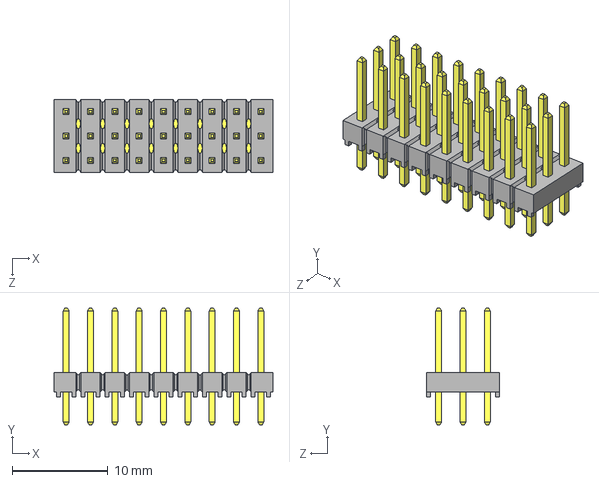
[picture p58: CAD file, 2022-07-18]
Models/SAMTEC_MTSW-109-24-G-T-225.step
22.9 x 12.2 x 7.62 mm
_TSW-109-24-T-T_body.stp
_T-1S6-17-TSW-1-24-9-T.stp
