Skyhawkson/Skyhawkson-KiCAD-Libraries/Models/PHOENIX_1861933_01_SPTAF-1-2-3-5-IL.step

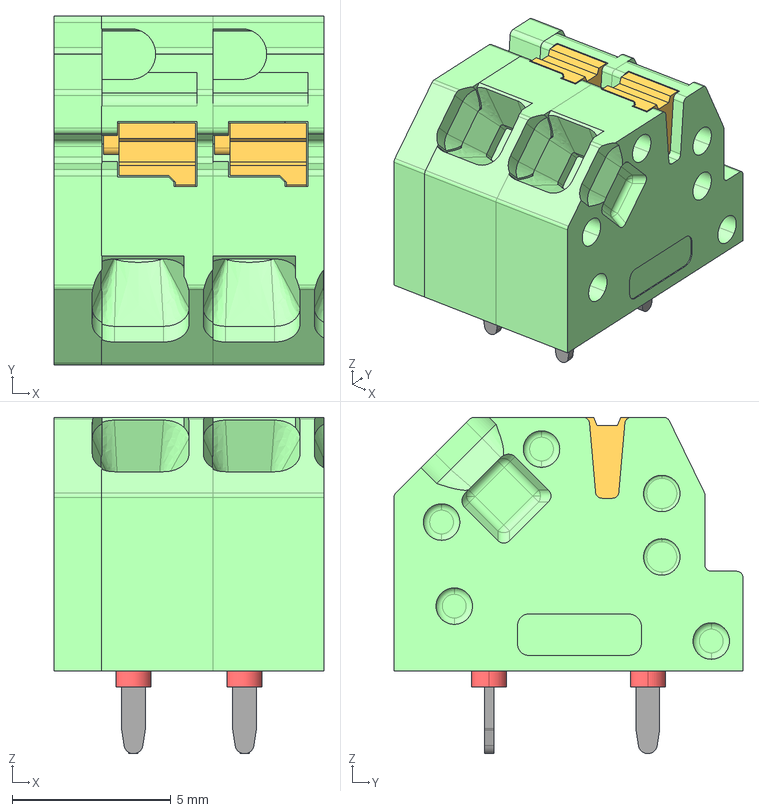
[picture p59: CAD file, 2022-07-17]
Models/PHOENIX_1861933_01_SPTAF-1-2-3-5-IL.step
8.50 x 11.0 x 10.6 mm
Bohrloch x 4
SPTAF_1-3.5_housing x 2
SPTAF-0-DKL.1
