Skyhawkson/Skyhawkson-KiCAD-Libraries/Models/MOLEX_73391008X.step

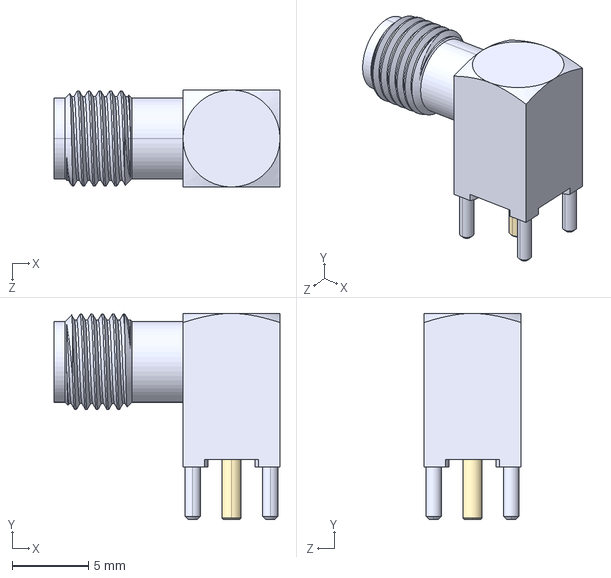
[picture p60: CAD file, 2022-07-17]
Models/MOLEX_73391008X.step
14.8 x 13.5 x 6.35 mm
