Skyhawkson/Skyhawkson-KiCAD-Libraries/Models/MOLEX_73391007X.step

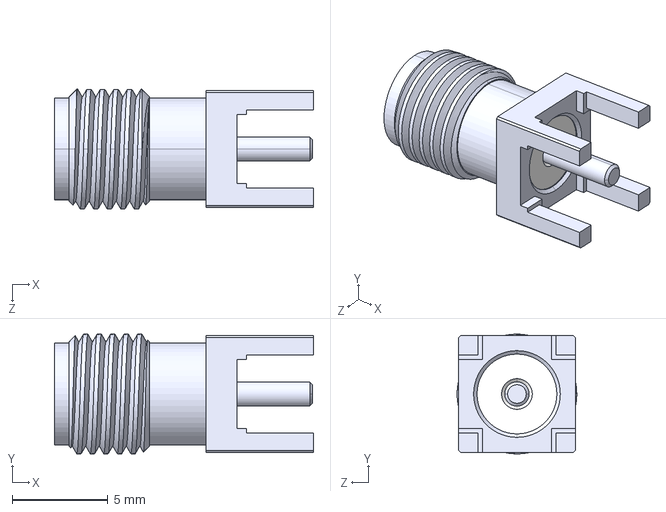
[picture p61: CAD file, 2022-06-06]
Models/MOLEX_73391007X.step
13.5 x 6.24 x 6.24 mm
