Skyhawkson/Skyhawkson-KiCAD-Libraries/Models/UBLOX_ZOE_S-LGA51.step

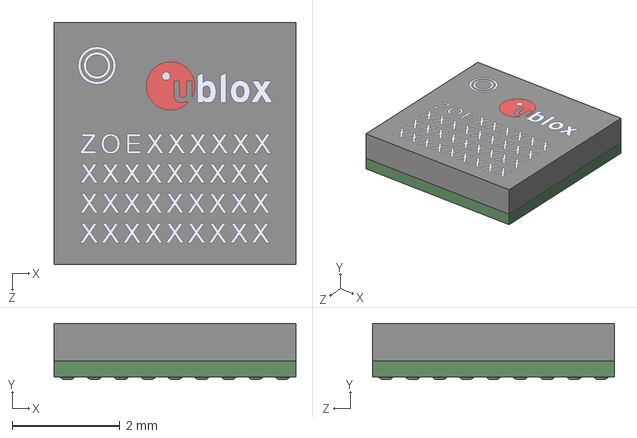
[picture p62: CAD file, 2022-06-04]
Models/UBLOX_ZOE_S-LGA51.step
4.50 x 1.04 x 4.50 mm
U-Blox_ZOE_S-LGA51_body.STEP
u-Blox_ZOE_S-LGA51_ball.STEP x 51
