Skyhawkson/Skyhawkson-KiCAD-Libraries/Models/GCT_USB4110-GF-A.step

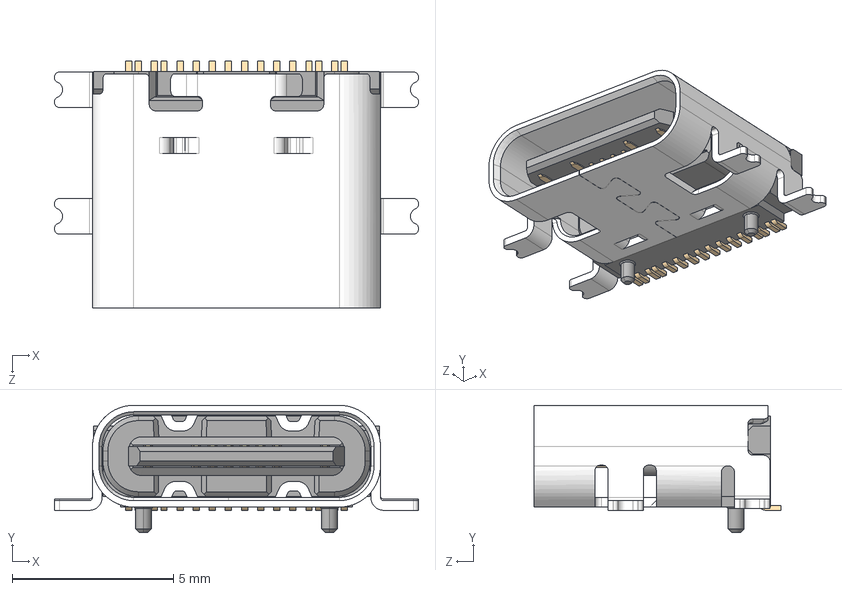
[picture p63: CAD file, 2022-06-04]
Models/GCT_USB4110-GF-A.step
11.3 x 3.96 x 7.68 mm
