Skyhawkson/Skyhawkson-KiCAD-Libraries/Models/GENERIC_0805_CAP.step

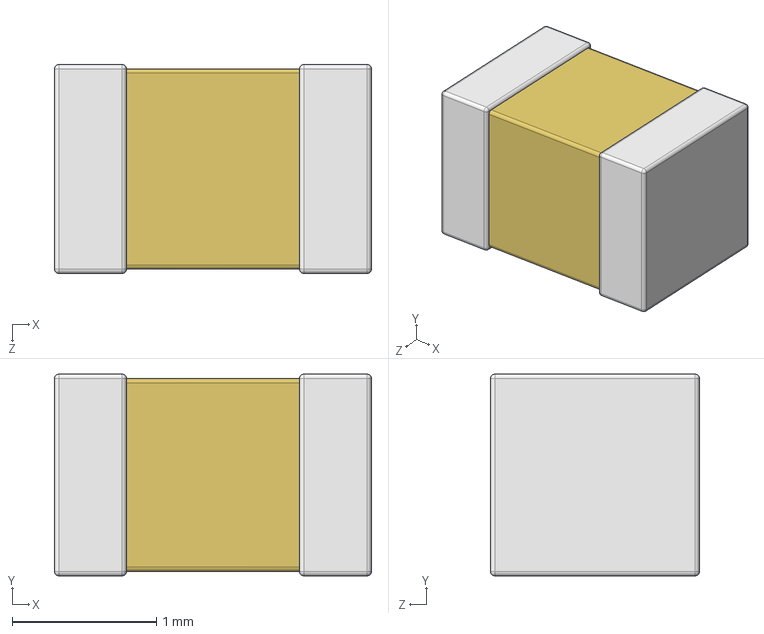
[picture p64: CAD file, 2022-06-04]
Models/GENERIC_0805_CAP.step
2.20 x 1.40 x 1.45 mm
