Skyhawkson/Skyhawkson-KiCAD-Libraries/Models/TE_HTU20D(F).step

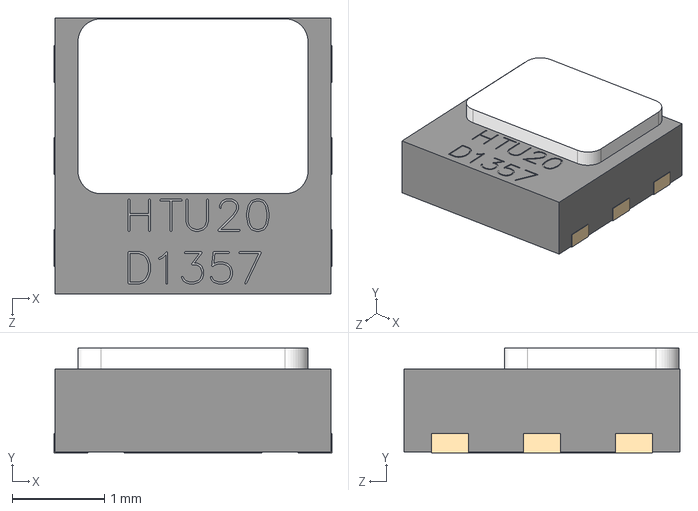
[picture p65: CAD file, 2022-06-04]
Models/TE_HTU20D(F).step
3.02 x 1.14 x 3.00 mm
