Skyhawkson/Skyhawkson-KiCAD-Libraries/Models/BOSCH_BNO055.step

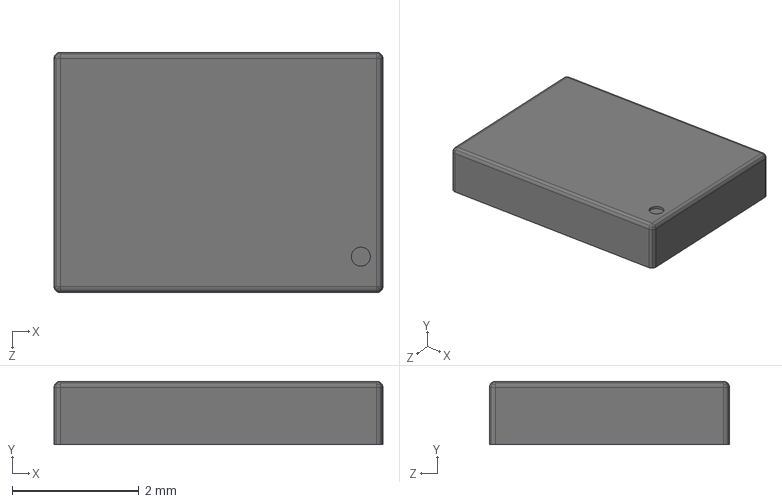
[picture p66: CAD file, 2022-06-04]
Models/BOSCH_BNO055.step
5.20 x 1.00 x 3.80 mm
Component3.step.step.step
BNO055 v3.step.step.step
