Skyhawkson/Skyhawkson-KiCAD-Libraries/Models/GCT_USB4105.step

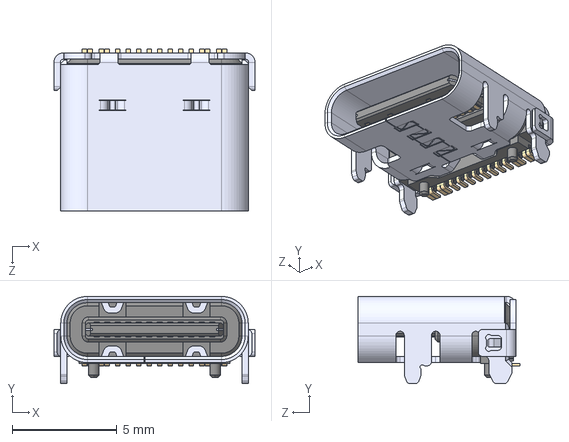
[picture p67: CAD file, 2022-06-04]
Models/GCT_USB4105.step
9.58 x 4.16 x 7.71 mm
