Skyhawkson/Skyhawkson-KiCAD-Libraries/Models/OMRON_2SMPB-02B.step

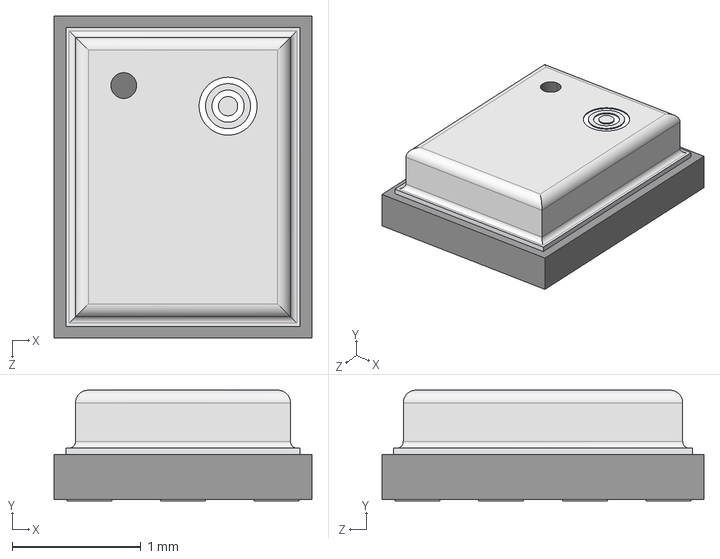
[picture p68: CAD file, 2022-05-30]
Models/OMRON_2SMPB-02B.step
2.00 x 0.86 x 2.50 mm
