Skyhawkson/Skyhawkson-KiCAD-Libraries/Models/ST_16-TFLGA_3x3.step

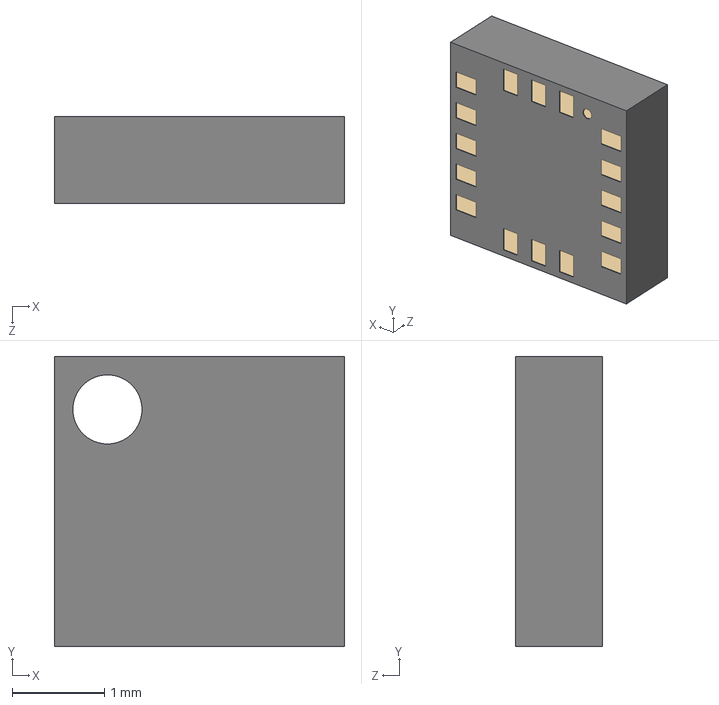
[picture p69: CAD file, 2022-05-30]
Models/ST_16-TFLGA_3x3.step
3.15 x 3.15 x 0.94 mm
