Skyhawkson/Skyhawkson-KiCAD-Libraries/Models/NXP_CASE 1317A-03.step

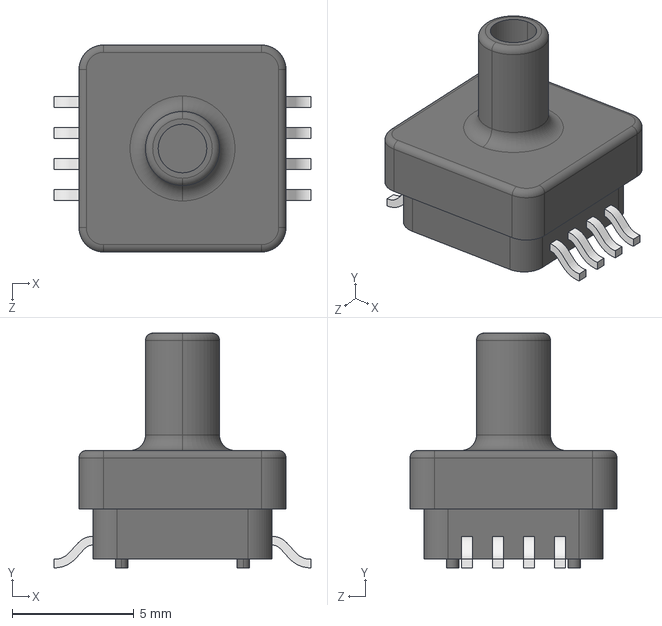
[picture p70: CAD file, 2022-05-30]
Models/NXP_CASE 1317A-03.step
10.6 x 9.65 x 8.51 mm
