Skyhawkson/Skyhawkson-KiCAD-Libraries/Models/BMX160.step

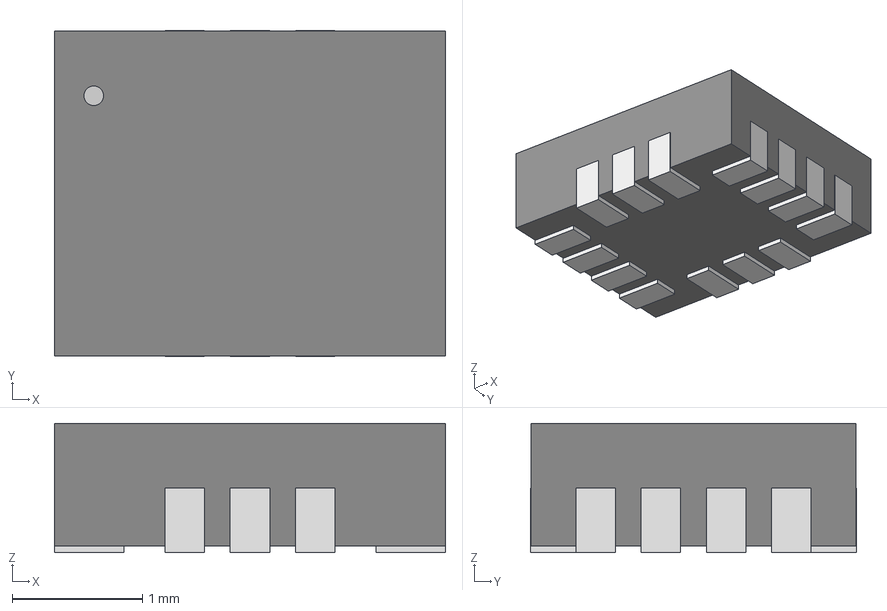
[picture p71: CAD file, 2022-05-30]
Models/BMX160.step
3.00 x 2.50 x 0.993 mm
