Skyhawkson/Skyhawkson-KiCAD-Libraries/Models/UBLOX_MAX-8.step

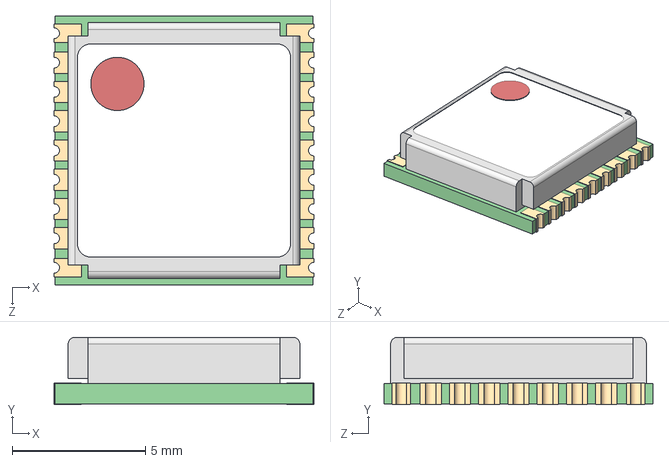
[picture p72: CAD file, 2022-05-17]
Models/UBLOX_MAX-8.step
9.75 x 2.52 x 10.1 mm
