Skyhawkson/Skyhawkson-KiCAD-Libraries/Models/UBLOX_SAM-8.STEP

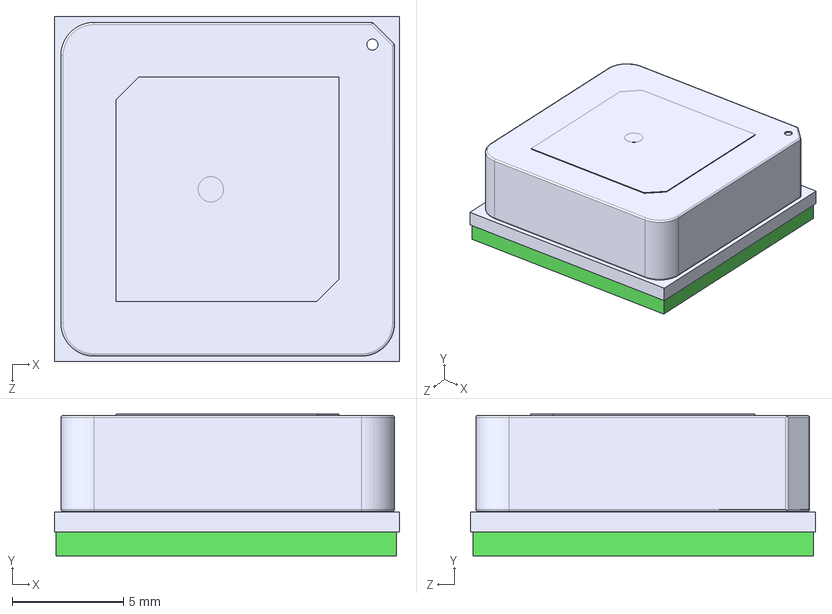
[picture p73: CAD file, 2022-05-17]
Models/UBLOX_SAM-8.STEP
15.5 x 6.38 x 15.5 mm
Sam cavity.STEP.step
SAM PCB.STEP.step
SAM ANT.STEP.step
