Skyhawkson/Skyhawkson-KiCAD-Libraries/Models/NRD_QFN20_4x4.step

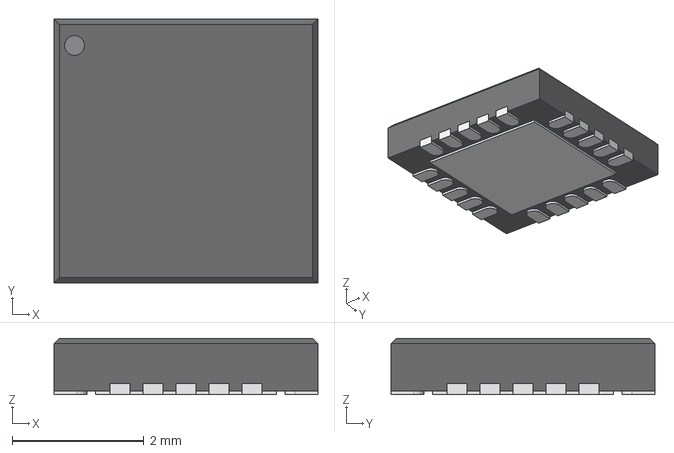
[picture p74: CAD file, 2022-05-17]
Models/NRD_QFN20_4x4.step
4.00 x 4.00 x 0.85 mm
