Skyhawkson/Skyhawkson-KiCAD-Libraries/Models/ST_STM32F446.STEP

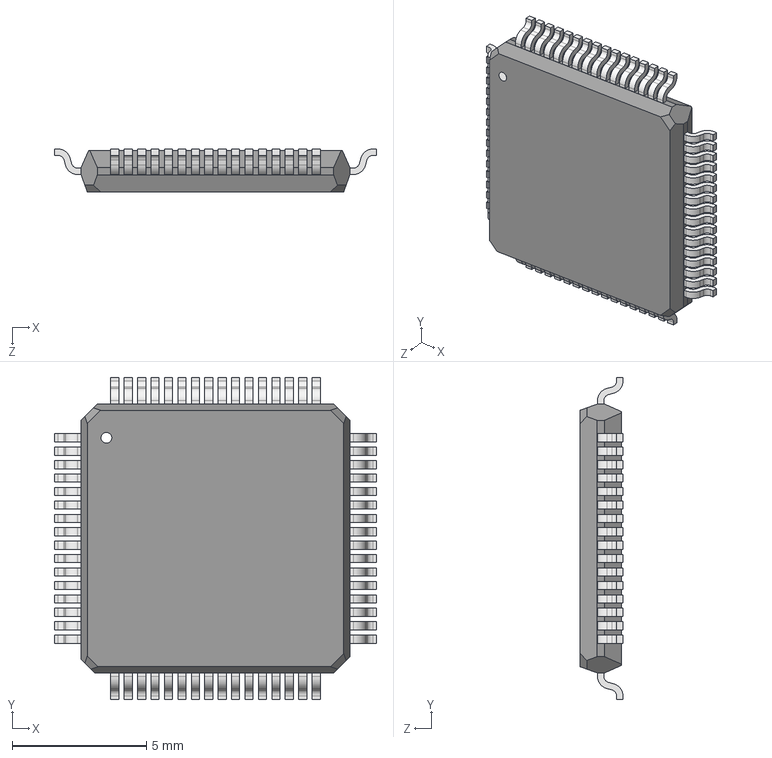
[picture p75: CAD file, 2022-05-15]
Models/ST_STM32F446.STEP
12.0 x 12.0 x 1.60 mm
