Skyhawkson/Skyhawkson-KiCAD-Libraries/Models/BOSCH_BMI085.STEP

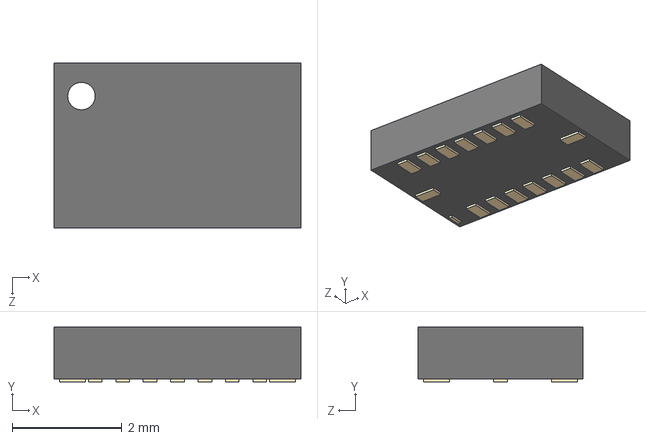
[picture p76: CAD file, 2022-03-18]
Models/BOSCH_BMI085.STEP
4.50 x 1.00 x 3.00 mm
