Skyhawkson/Skyhawkson-KiCAD-Libraries/Models/ESP32-WROOM32.step

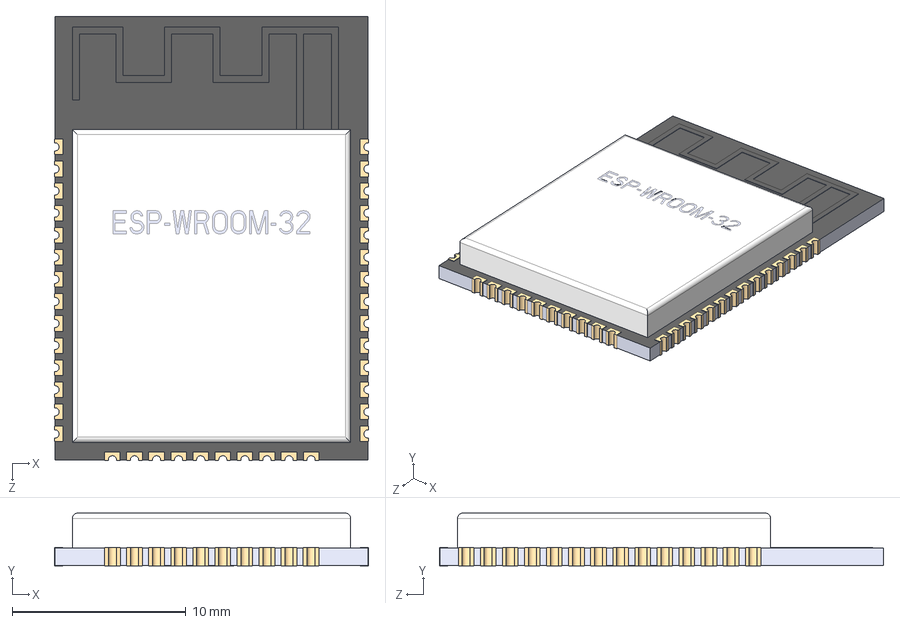
[picture p77: CAD file, 2022-02-09]
Models/ESP32-WROOM32.step
18.1 x 3.04 x 25.5 mm
