Skyhawkson/Skyhawkson-KiCAD-Libraries/(list of files, cad)

Other CAD files:
Models/HW_MPR_Long-Port_Gage.STEP
Models/GENERIC_0402_RES.step
Models/GENERIC_0603_IND.step
Models/GENERIC_0603_CAP.step
