Skyhawkson/Skyhawkson-KiCAD-Libraries/Reference Documents/Component Manufacturer Prefixes.xlsx

Manufacturer | Abbreviated Prefix | Note
Abracon | ABRACON
adesto Technologies | ADESTO
Allegro Microsystems | ALLEGRO
Amphenol | AMP
Analog Devices | AD | Companies purchased by AD retain original prefixes
BIVAR | BIVAR
Bosch | BOSCH
Bourns | BOURNS
C&K Switches | CK
CNC Tech | CNC
Diodes Incorporated | DIODES
Espressif | ESPRESSIF
FTDI Chip | FTDI
Global Connector Technology | GCT
Harwin | HARWIN
Hirose | HRS
Honeywell | HW
Integrated Silicon Solutions, Inc | ISSI
Keystone Electronics Corp. | KEYSTONE
Littelfuse | LF
Maxim Integrated | MAXIM | Now owned by AD
Microchip Technology | MCP
Molex | MOLEX
muRata Manufacturing Co. | MURATA
Nexperia | NEXPERIA
Nordic Semiconductor | NRD
OMRON | OMRON
OSRAM/OSRAM SYLVANIA | OSRAM
Phoenix Contact | PHOENIX
Rohm Semiconductor/ROHM Co. | ROHM
Samtec | SAMTEC
ST Microelectronics | ST
SunLED | SUNLED
TE Connectivity | TE
Texas Instruments | TI
Torex Semiconductor, Ltd. | TOR
uBlox | UBLOX
Würth Elektronik | WE
