Skyhawkson/Skyhawkson-KiCAD-Libraries/(threads)

Thread 1 (2024-02-08):

BIVAR light pipes do not fit in mechanical mounting holes

Skyhawkson, 2024-02-08:
Bivar lightpipes are struggling to press into mounting holes. Should be a snug fit, but right now they're not able to sit flush with the board.
Not sure if manufacturing tolerance issue or footprint issue.

Thread 2 (2024-02-08):

[Concern] TI_SN74HCS595PWR could use more paste

Skyhawkson, 2024-02-08:
Thin paste openings in the stencil lead to a minimal amount of paste being deposited, making visual soldering verification tricky. Reducing the clearance by half would probably help alleviate the problem
