Skyhawkson/Skyhawkson-KiCAD-Libraries/Reference Documents/YJSP Component Naming Conventions.pdf

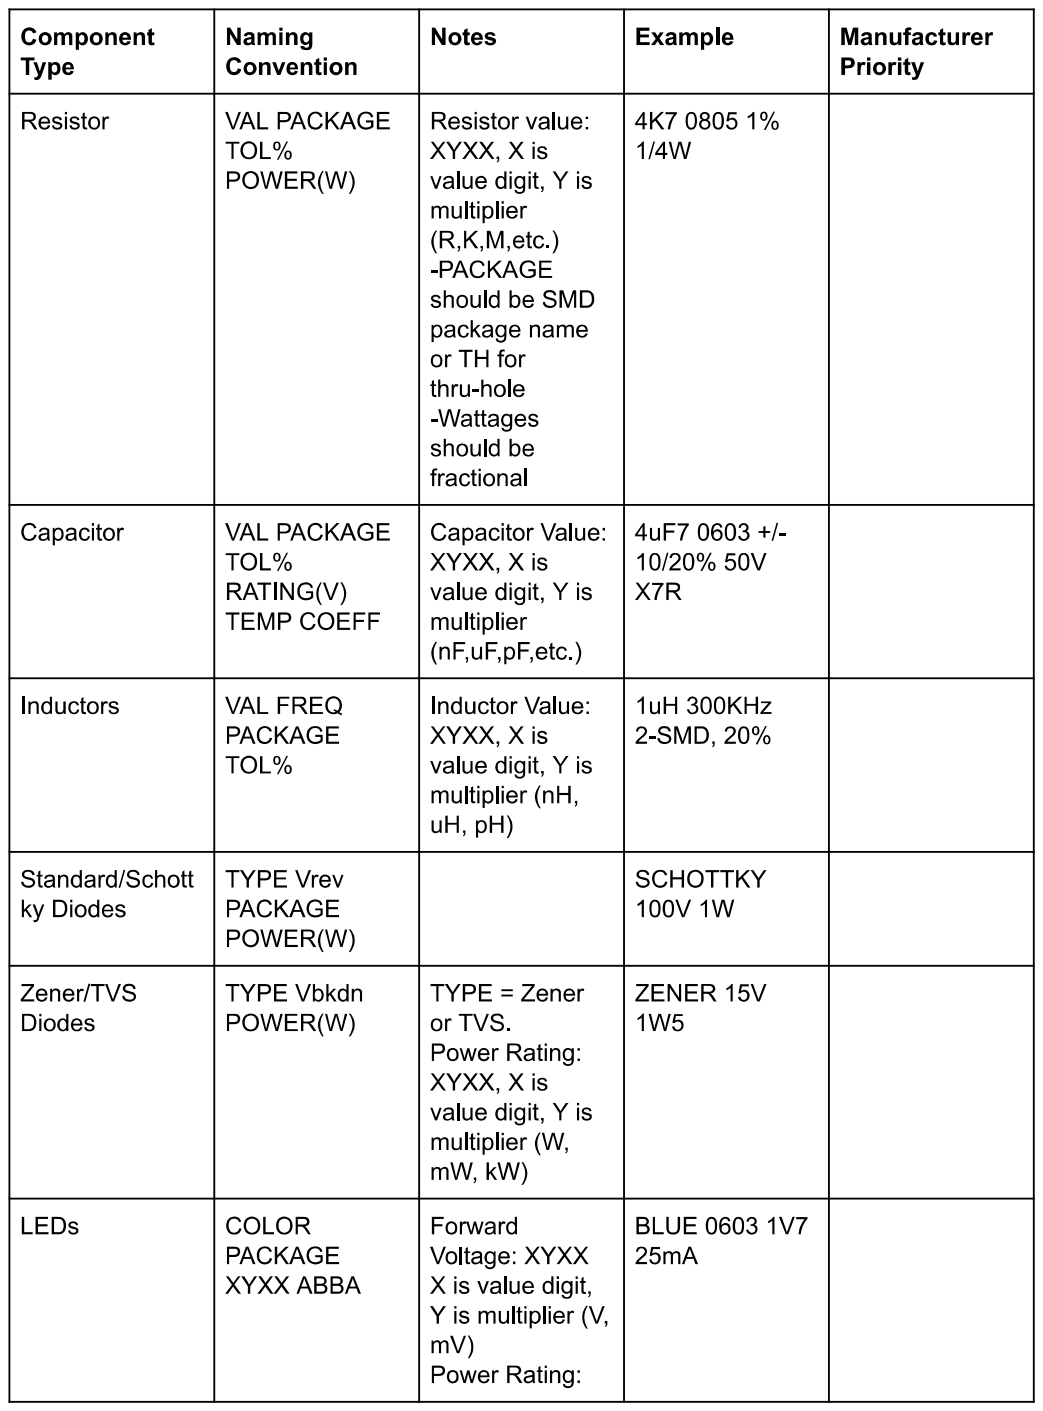
[picture p78: page 1]

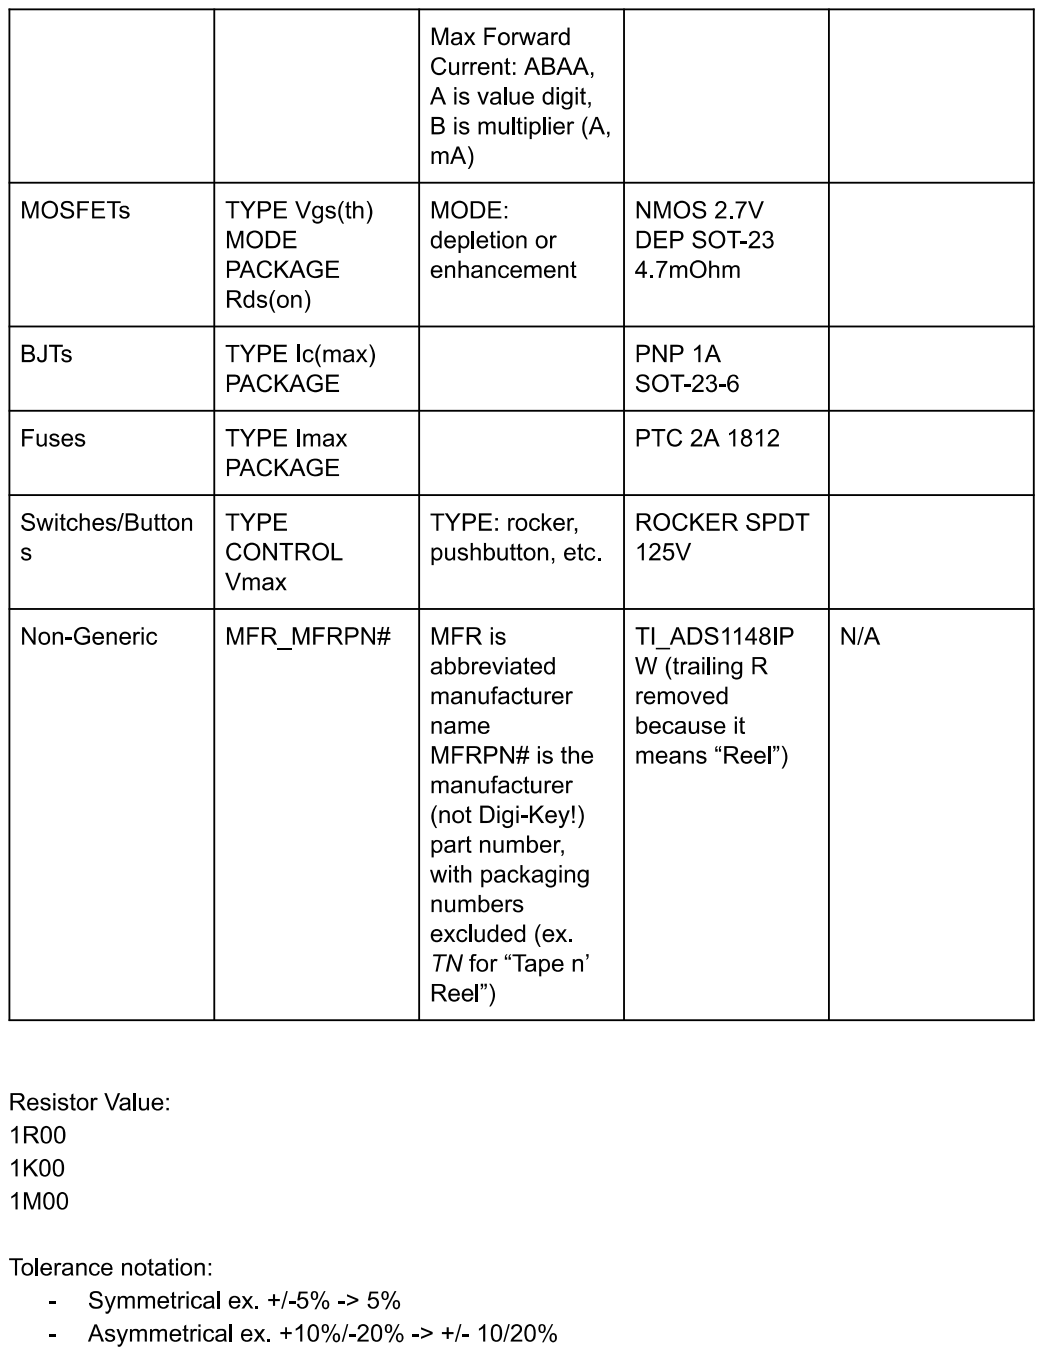
[picture p79: page 2]
