Skyhawkson/Skyhawkson-KiCAD-Libraries/Reference Documents/YJSP Derating Guide.pdf

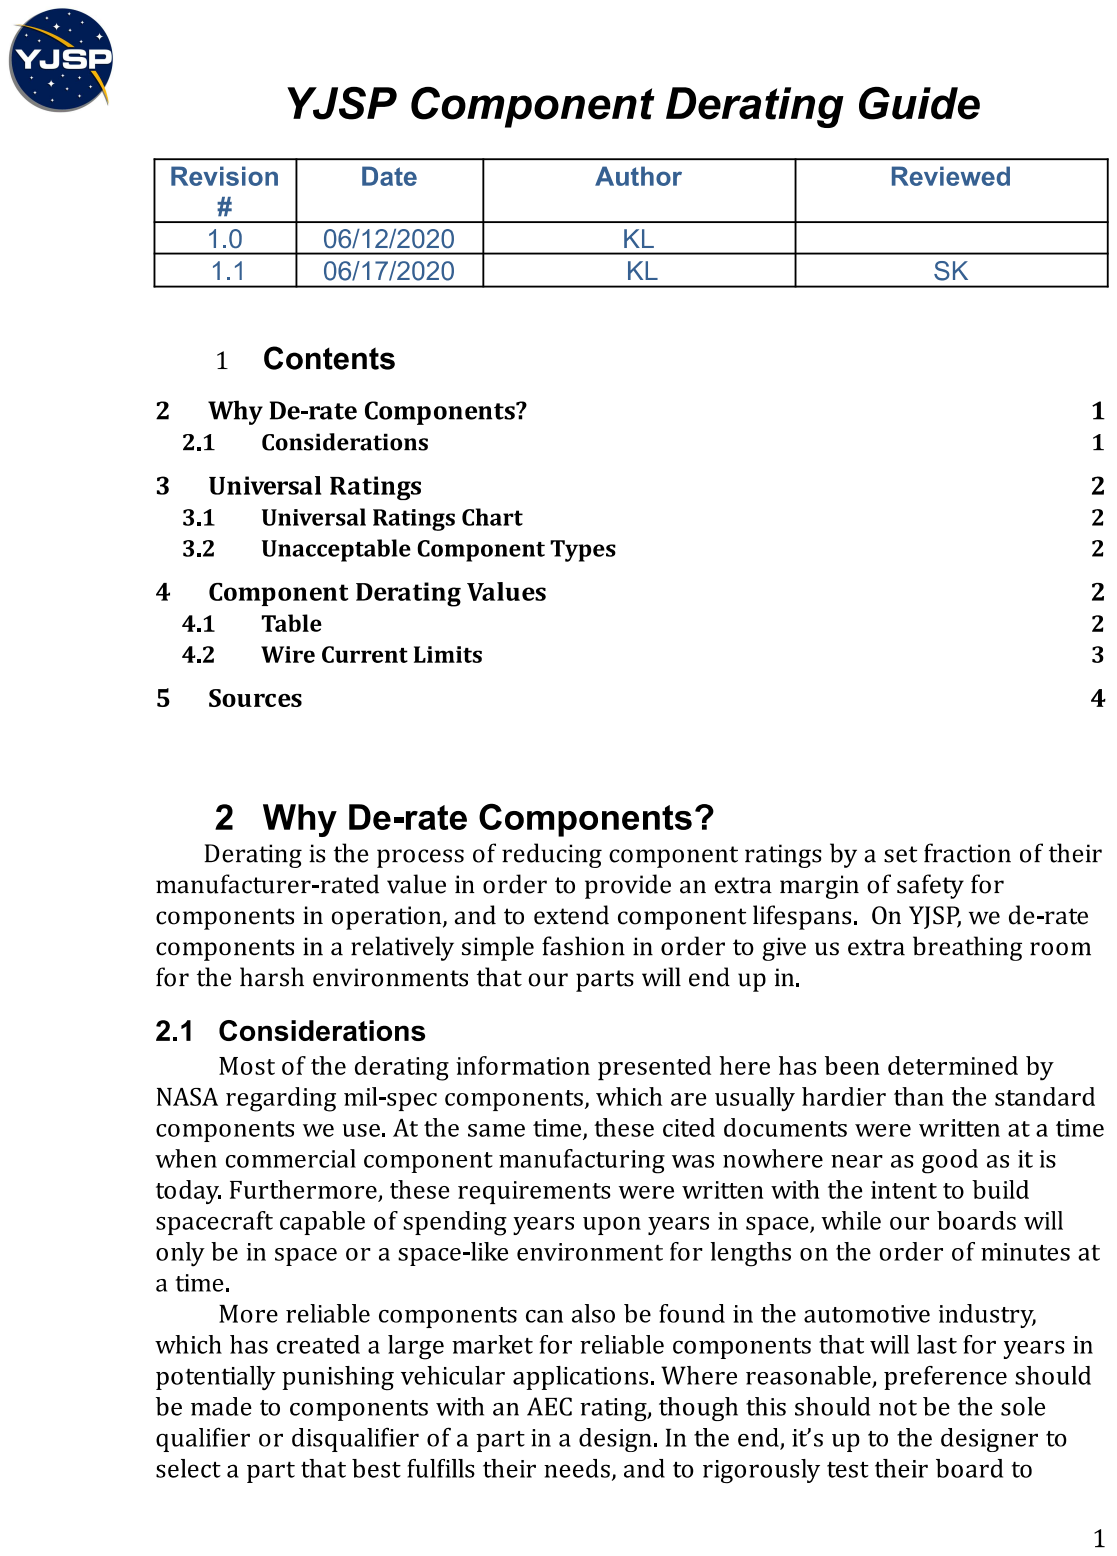
[picture p80: page 1]

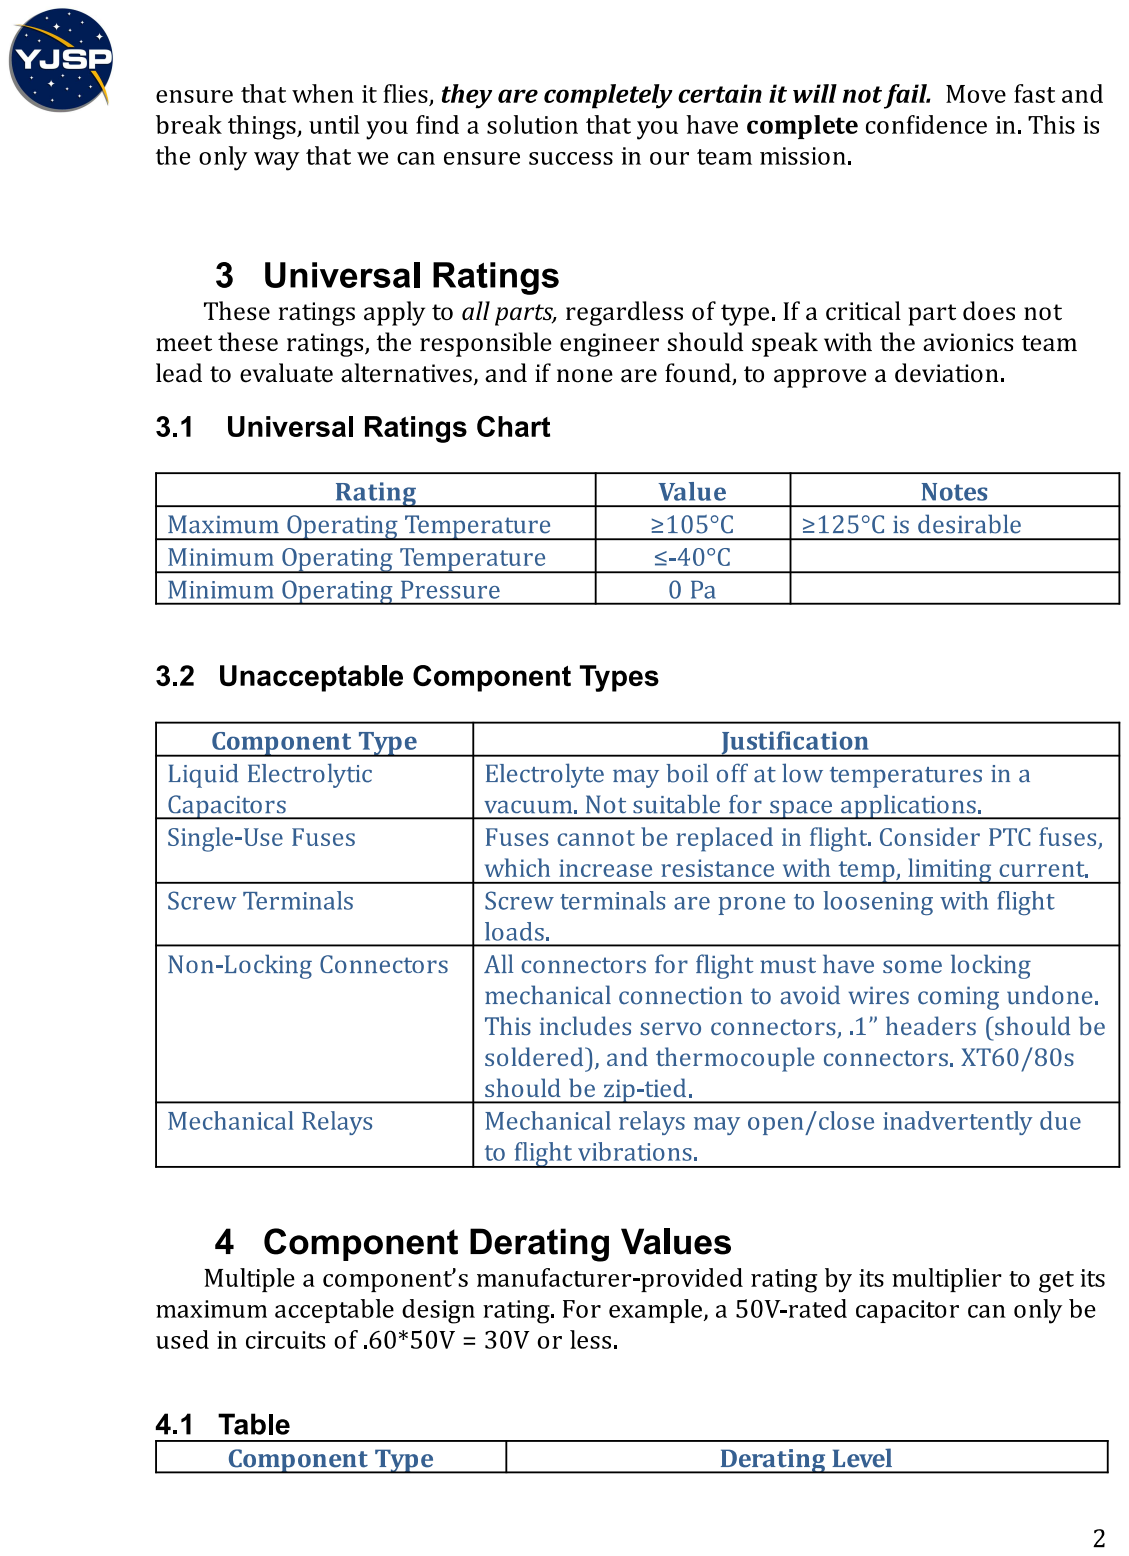
[picture p81: page 2]

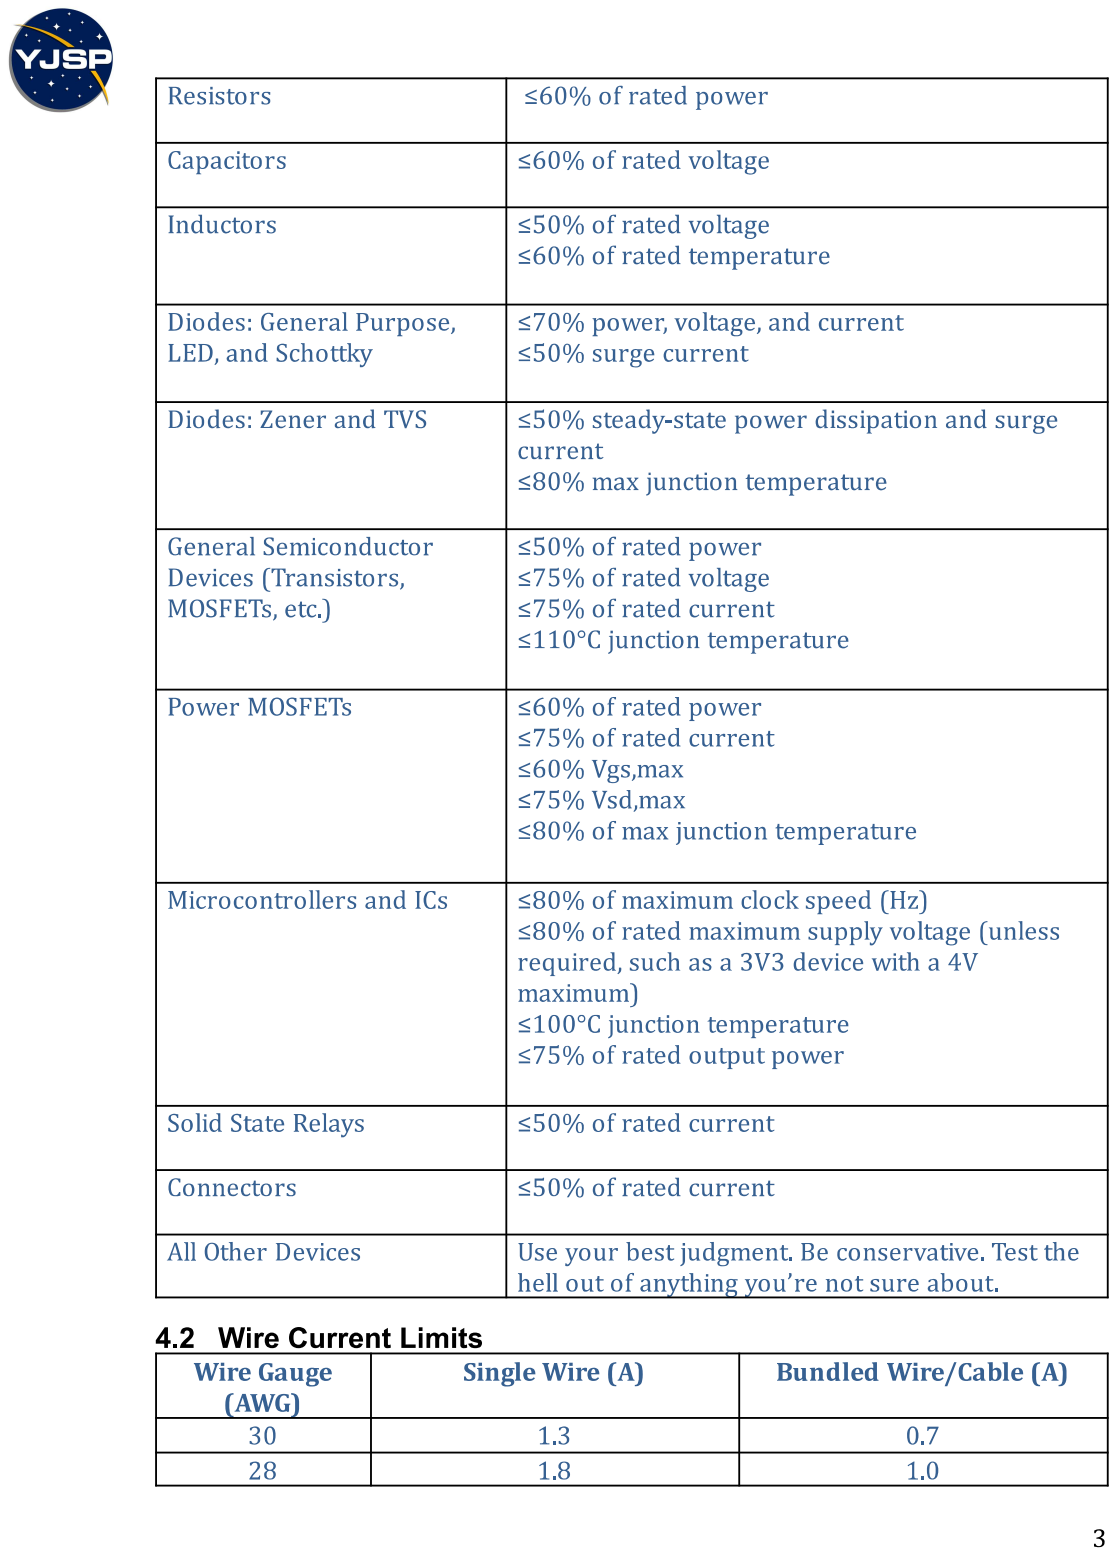
[picture p82: page 3]

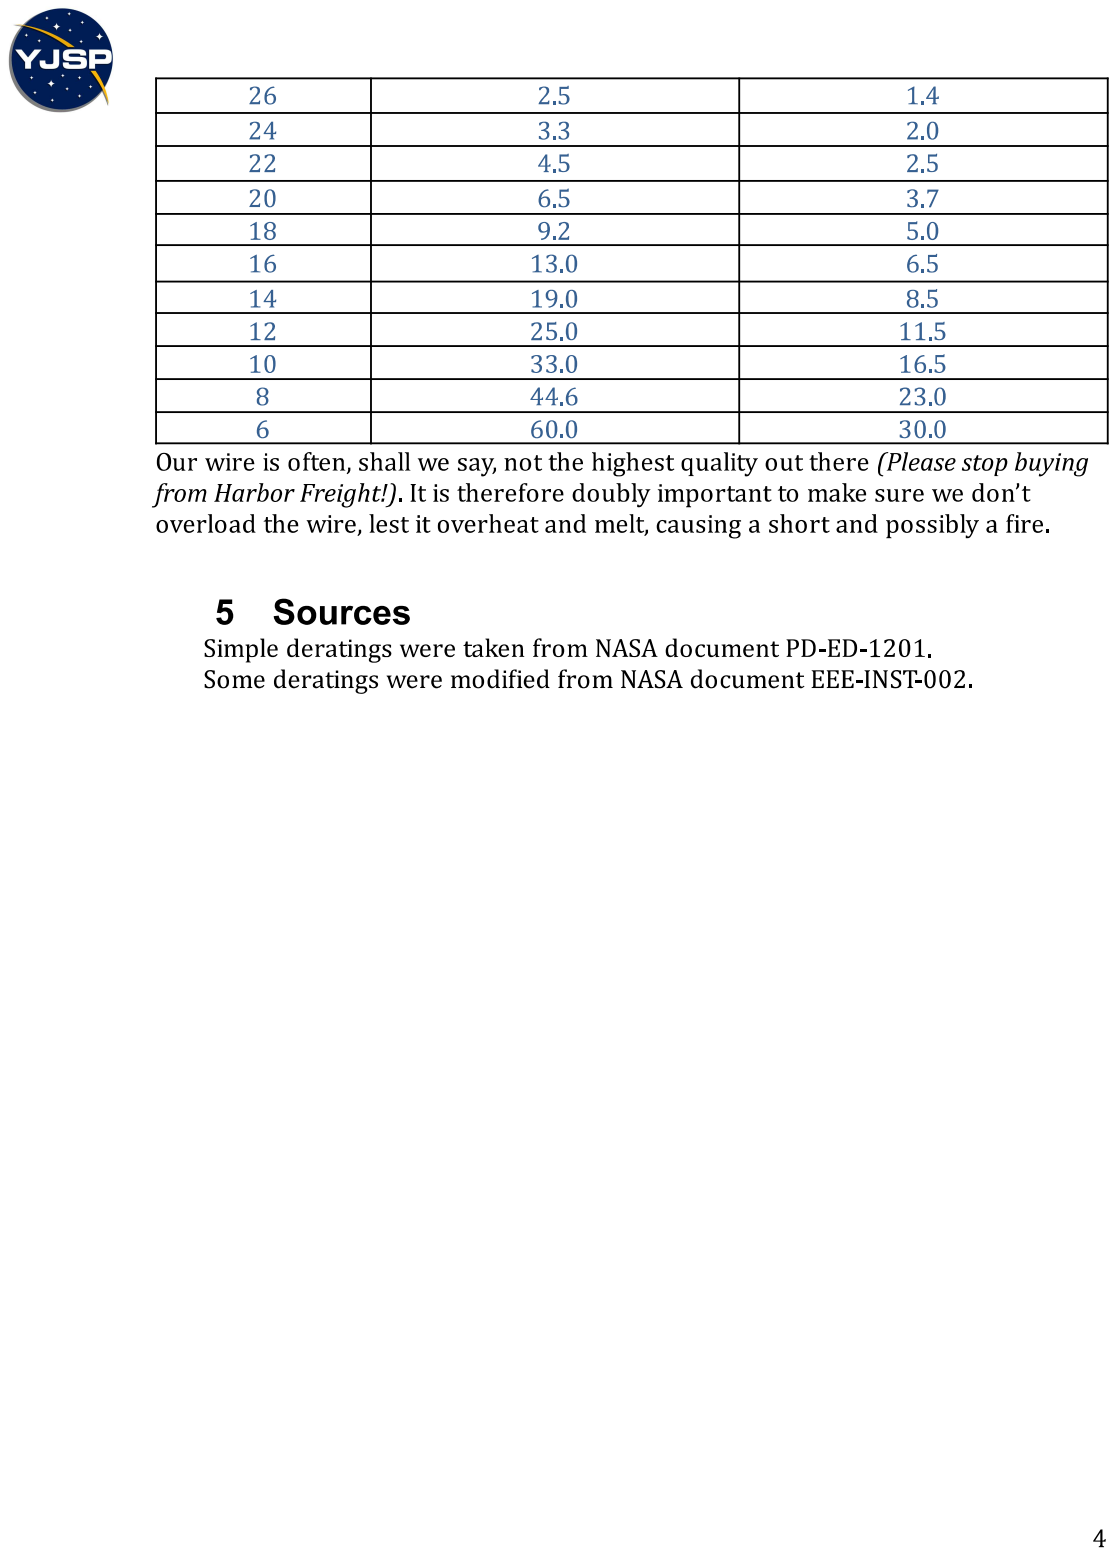
[picture p83: page 4]
