Skyhawkson/Skyhawkson-KiCAD-Libraries/(commit log)

2022-02-09 Added ESP-32-WROOM-32D
    Added my first component and set up general library structure
    [ESP32-WROOM32.step]
2022-03-18 Added Bosch BMI085
    [BOSCH_BMI085.STEP]
2022-05-15 Added STM32F446 Symbol, FP, and model
    [ST_STM32F446.STEP]
2022-05-17 Added two GPS modules and fixed fab layer
    - Added MAX-8
    - Added SAM-M8
    - Fixed F.Fab on all footprints to remove center crosses, replace with designators in center
    - Properly mapped F.Fab outlines to component outlines
    [NRD_QFN20_4x4.step, UBLOX_MAX-8.step, UBLOX_SAM-8.STEP]
2022-05-30 Add BMX160, H3LIS100 and 331, modified desc
    - Added BMX160 Sym, FP, Model
    - Added H3LIS100 and H3LIS331 symbols
    - Adjusted BMI085 to match name placement with other devices
    - Added digikey descriptions to all current symbols
    [BMX160.step]
2022-05-30 Added Pressure Sensor
    - Added NXP_CASE-1317A-03 footprint
    - Added NXP_MPXHZ6250AC6T1 symbol
    [NXP_CASE 1317A-03.step, ST_16-TFLGA_3x3.step]
2022-05-30 Added OMRON 2SMPB-02B
    - Added symbol
    - Added footprint and step model
    [OMRON_2SMPB-02B.step]
2022-06-04 Added Parts and descriptions
    - Added USB4105 connector
    - Added USB4110 connector
    - Ported over capacitor library in entirety
    - Added HTU20D sensor
    - Added ZOE GPS module
    - Updated descriptions to match digikey descriptions
    [BOSCH_BNO055.step, GCT_USB4105.step, GCT_USB4110-GF-A.step, GENERIC_0603_CAP.step, GENERIC_0805_CAP.step, TE_HTU20D(F).step, UBLOX_ZOE_S-LGA51.step]
2022-06-06 Added M3 PTH and Molex SMA jack
    [MOLEX_73391007X.step]
2022-07-17 Fixed bottom pin row centering on ESP32 symbol
2022-07-17 Added Three Connectors
    - Added MOLEX 1040310811 and Model
    - Added MOLEX SD-73391-008 and Model
    - Added PHOENIX SPTAF1/2-3,5 and Model
    [MOLEX_1040310811.step, MOLEX_73391008X.step, PHOENIX_1861933_01_SPTAF-1-2-3-5-IL.step]
2022-07-18 Added 3x9 pin header footprint and symbol
    - Added SAMTEC_MTSW-109-24-G-T-225 model
    - Added SAMTEC_MTSW-109-24-G-T-225 footprint
    [SAMTEC_MTSW-109-24-G-T-225.step]
2022-07-20 Completed Skyhawkson-Connectors and moved Skyhawkson-RF
    - Added CNC 3220-10-0300-00 model and footprint
    - Added TE-2337019 and footprint
    - Initialized Skyhawkson-Diodes and TVC
    - Moved Skyhawkson-RF over from wrong folder
    [CNC_3220-10-0300-00.step]
2022-07-20 Completed Skyhawkson-Diodes transfer
    - Added Littelfuse AXGD1 footprint and model
    - Added ONSEMI SOT-23 footprint and Zener diode
    [LF_AXGD10603.step, ONSEMI_SOT-23_(CASE 318).step]
2022-07-21 Added Adesto Flash
    [ADESTO_8S4_(SON-8).step]
2022-07-21 Fixed Adesto 8S4 and Pin 1 markings
    - Deleted extra Adesto 8S4 silkscreen line
    - Assigned Adesto 8S4 to appropriate footprint
    - Added missing Pin 1 markers to multiple devices
    - Added outline box to ESP32 wroom32D
2022-07-21 Added ACS711, FTDI adapter, and ISSI LED Driver
    [ALLEGO_LC_(SOIC-8).step, FTDI_000565_(SSOP-20).step, ISSI_QFN-24_4x4.step]
2022-07-22 Added four new parts
    - Added MAX7456
    - Added MCP2515
    - Added NEXPERIA 74LVC245A
    - Added NEXPERIA NVT2006
    [MAXIM_MAX7456.step, MCP_C04-2051A_(SOIC-18).step, NEXPERIA_SOT360-1_(TSSOP20).step, NEXPERIA_SOT403-1_(TSSOP-16).step, TI_D0008A_(SOIC-8).step]
2022-07-23 Completed Skyhawkson-ICs library
    - Added NEXPERIA PCA9685
    - Added TI TCA9546
    - Added TI TVP5150
    [NEXPERIA_SOT361-1_(TSSOP-28).step, TI_PBS_(S-PQFP-G32).step, TI_PW0016A_(TSSOP-16).step]
2022-07-23 Created Skyhawkson-Inductors Coils and Beads library
    - Added library
    - Added GENERIC_0603_IND model
    - Added 2NH7_0603 part
    [GENERIC_0603_IND.step]
2022-07-23 Completed Inductor library transfer
    - Added MURATA JELF243A footprint/model
    - Added remaining inductor parts
    [MURATA_JELF243A_0026S-01_(0603).step]
2022-07-25 Completed LED library and relocated Inductor Library
    - Added all components for LED library
    - Moved inductor library to correct folder
    [LITE-ON_LTP-305X.step, OSRAM_0603.step, OSRAM_0805.step, SUNLED_XZxxxxxx45S-9.step, WS_WS2812B-2020.step]
2022-07-25 Added Skyhawkson-Miscellaneous library and abracon oscillators
    [ABRACON_ABM8.step, ABRACON_ABS25.step]
2022-07-25 Completed Miscellaneous Library Transfer
    - Added PTS815
    - Added Murata PKMCS
    - Added Harwin S1751 to Connectors instead of Misc.
    [CK_PTS815.step, HARWIN_S1751-XX.step, MURATA_PKMCS.step]
2022-07-25 Create Skyhawkson-Power Symbols.kicad_sym
    Added all power symbols previously existing
2022-07-27 Completed Power IC library transfer
    [MIC_SOT23-5LD-PL-1.step, ROHM_HTSOP-J8.step, TOR-SOT25.step]
2022-08-08 Transferred resistor library
    - Added all resistor symbols
    - Added resistor 0603 and 0805 footprints (still need 3D models
2022-08-09 Completed POWERDI5 and added 0603 and 0805 resistor models
    - Added details to DXT2011 diode
    - Added resistor step files for respective 0603 and 0805 generic components
    [DIODES_POWERDI5.step, GENERIC_0603_RES.step, GENERIC_0805_RES.step]
2022-08-25 added Rohm HSMT8 package and footprint
    [ROHM_HSMT8_NOMINAL.step]
2022-08-26 Completed Library Transfer
    - Completed pin assignment and tested ROHM_RQ3E120AT
    - Added Vishay Si2367DS
2022-12-10 Adjusted some ref des spacings
2023-01-03 Fixed GND pin label to display properly
2023-01-15 Added MAX77857
    - Added MAX77857 power symbol
    - Added MAXIM_W35282A2+ footprint and step file
    [MAXIM_W352A2+1.STEP]
2023-01-21 Added Banana Jack Part and TI Hall sensor symbols
    - Added Keystone 575-4 banana jack symbol and footprint
    - Added TMAG 5170-Q1 symbol
    - Added TMAG 5273-Q1 symbol
    [KEYSTONE_575-4.STEP]
2023-02-12 Pushing before KiCAD 7 and adding TI_DBV0006A
    Adding TI_DBV0006A fp
    [GENERIC_SOT23-6.STEP]
2023-03-06 Added ADIN1110
    [AD_ADIN1110.step]
2023-03-18 Completed AMP_MSPE-J2L0-B01
    - Finished symbol links
    - Added FP and model
    [AMP_MSPE-J2L0-B01-REVT3.STEP]
2023-03-20 Added LF 0494005 and footprint
    [LF_494_(0603).STEP]
2023-03-22 Added 1K69 ohm resistor
2023-03-23 Update Skyhawkson-Resistors.kicad_sym
    Added two more resistors
2023-04-02 Added OSH 2-layer template, updated TOR SOT-89,
    [TOR_SOT89-5.STEP]
2023-05-09 Worked on Correcting Reset Circuit
    - Fixed MBT2222A orientation after consulting sparkfun datasheet
    - Added a manual button
    - Properly configured pull-up
2023-05-29 Added parts for Forerunner Cubic Mainboard
    - Added SAMTEC LSS-120 standalone connector
    - Added SAMTEC LSS-120 in 12mm stacking config for forerunner cubic
    - Added DO-214BA generic footprint
    - Added Microchip LSM115J using the 'MCP' abbreviation
    - Added+24V and 24V_RTN power signals
    - Added various 0603 capacitors and resistors
    [GENERIC_DO-214BA.STEP, SAMTEC_LSS-120-02-F-DV-A.stp]
2023-06-05 Added Inductor footprints/symbols, oscillator, and capacitor
    - Added BOURNS SRP5030TA footprint and symbol
    - Added WE CNSW footprint and symbol
    - Added 25MHz abracon ABM8 oscillator
    - Added Additional capacitors
    [BOURNS_SRP5030TA.STEP, WE-CNSW-0603.STEP]
2023-06-19 Update Skyhawkson-Resistors.kicad_sym
    - Added 1.5K 0603
2023-09-23 Completed ADS131M04PWR
    [TI_PW0020A_(TSSOP-20).STEP]
2023-09-29 Fixed offset pin on stacking connector to align with grid
2023-10-04 Added WIP CAT16 resistor array symbol
2023-10-05 Completed CAT16-F4 Resistor array
    - Fixed symbol
    - Added Footprint
    [BOURNS_CAT16-F4.STEP]
2023-11-05 Exposed Pad fixes and adding Light Pipe and EEPROM
    - Fixed ESP32-WROOM-32D exposed pad not connected in symbol
    - Fixed ADIN1110 exposed pad not connected in footprint
    - Added MCP_24LC32AT-E/OT EEPROM
    - Added BIVAR_SLP3-150-XXX-F light pipe
    - Light pipe foorprint still pending completion, also need to add shorter lens version
    [BIVAR_SLP3-150-250-F.IGS]
2023-11-09 Updated Bivar Light Pipes
    - Finished footprint for SLP3-150-250-F
    - Added BIVAR_SLP3-150-100-F for a shorter lens version
    [BIVAR_SLP3-150-100-F.IGS]
2023-11-10 More tetris and footprint fixes
    - Replaced light tube with better model
    - Defined connector/panel stickout to 2mm on S and W sides
    - Updated all footprints
    - Added keepouts for interference with power board connectors
2023-11-11 Fixes/tweaks
    - Adjusted SPE connector bottom keepout to allow for placement underneath for ESD components
    - Fixed ESP32 EP name to 'EP' instead of '39'
2023-11-12 Added plug body/stickout outline to connector FP
2023-11-18 Added 0402 resistor and cap set
    - need models for generic 0402's
2023-11-19 Updated 0402 footprints with proper models
    [GENERIC_0402_CAP.step, GENERIC_0402_RES.step]
2023-11-25 Piezo symbol change and pin fixes
    - Changed piezo symbol to better represent device
    - Updated various power pins to fix unnecessary ERC errors.
2023-11-25 Updated by joining pads with ctrl-e to fix DRC errors
    - couldn't connect traces to pads; selected the pads and joining copper in the footprint and cycled ctrl-e/ctrl-e to join
2023-12-07 Added new resistors
2024-01-02 Library Fixes
    - Adjusted SAMTEC LSS stacking via size to meet Oshpark manufacturing reqs
    - Removed extraneous silkscreen lines from BIVAR light pipes
    - Removed extraneous courtyard line from MCP-DO-214BA to clear DRC errors
2024-01-03 Update Skyhawkson-Capacitors.kicad_sym
    - Added 30pF 0603 ceramic cap
2024-01-17 Added WE_WL-SUTW model
    [WE_WL-SUTW.STEP]
2024-01-21 Forerunner Mainboard Assembly Hotfixes
    - Changed AMP_MSPE connector to BOM instead of 'NoBOM'
    - Fixed symbol ABRACON_ABM8-25.000MHZ-12-D2Y 'Value' field; was 27MHz D1X, now 25MHz D2Y
    - Fixed 1K5_0603 'Value' field from 0R to 1K5
    - Updated symbol 30PF_0603 'Value' field to 30 instead of 27
    - Updated symbol 220NF_0402 'Value' field to 0402 instead of 0603
    - Changed Wurth-CNSW-0603 pad paste clearance
    - Was -.1mm, now -.05mm
    - Moved CK_PTS815 footprint pads inwards by .1mm and changed pad paste clearance from -.1 to -0.0 mm to add more past and bridge gap found during assembly
    -Corrected BIVAR_SLP3-150-100-F to the right DKPN for the 100 size (was 250 size)
2024-01-29 Added parts and Graphics/Symbols library
    - Added WE_WL-SUTW footprint and 365nm UV LED symbol
    - Created Skyhawkson-Graphics symbol library, and populated with open-source symbols from the KiCAD device inbuilt library, and the OSHWA certification mark library
2024-01-29 Completed Keystone_1043P battery holder
    [KEYSTONE_1043P.STEP]
2024-01-30 Updated CHASSIS power flag to have visible value
2024-02-04 Added documents for reference, updated README for public release
    [Component Manufacturer Prefixes.xlsx]
2024-02-08 Added RP2040 symbol and FP
    [RPI_RP2040.STEP]
2024-02-18 Added HIROSE_FH12-16S-1SH(55) Model and Symbol
    - Added HIROSE_FH12-16S-1SH model
    - Added HIROSE_FH12-16S-1SH(55) symbol
    [HIROSE_FH12-16S-1SH.STEP]
2024-02-21 Completed HIROSE_FH12-16S-1SH footprint
2024-02-28 Changed Hirose Prefix, added Honeywell MPRL series transducer, updated manufacturer prefix table
    - Changed HIROSE prefix to HRS
    - Updated component manufacturer prefixes table
    - Added Honeywell MPR long port gage and no gage models
    - Added HW_MPR_Long-Port footprints
    - Added HW_MPRLS0025PA00001A symbol
    [Component Manufacturer Prefixes.xlsx, HW_MPR_Long-Port_Gage.STEP, HW_MPR_Long-Port_No-Gage.STEP]
