Skyhawkson/Skyhawkson-KiCAD-Libraries/(notices)

Notices in the files:
Models/SAMTEC_LSS-120-02-F-DV-A.stp:
author */ ('License CC BY-ND 4.0'),
